MudRunnerBaja/Eletronica/documentação/Placa do Display/Relatório Placa do Display.docx

# INTRODUÇÃO

Por conta do sucateamento da placa do display do carro e a alta dificuldade de manutenção, o subsistema de eletrônica optou por manufaturar uma nova placa do display.

# SUMÁRIO

# 1. OBJETIVO

Reduzir a frequência e a dificuldade de manutenção da placa através da manufatura de uma nova placa, além do aprimoramento do design e da documentação da placa e de seus componentes.

# 2. METODOLOGIA

O projeto e design da placa foi feito no software Fusion 360 da Autodesk. As medidas do capô e dos displays foram tiradas com um paquímetro. A partir das medidas, foram calculadas as margens de erro para o posicionamento dos displays e leds na placa. Optou-se por usar 1cm de margem exterior na placa. Por fim, as dimensões finais da placa são:

# 3. APRESENTAÇÃO

As dimensões da placa foram calculadas e documentadas no design de placas de circuitos impressos do Fusion 360 da Autodesk. Uma print pode ser vista no anexo (1ª figura). A segunda figura representa o design das trilhas da placa, inspirado na placa antiga.

O projeto das trilhas foi feito pensando na facilitação da confecção das trilhas da placa. Os pinos de entrada da placa não estão alinhados com os pinos na placa principal, porém, como os fios serão soldados na placa, pode-se rearranjá-los de forma que seus conectores se alinhem com a placa principal. Essa escolha é baseada na placa antiga e a ideia é representada pela figura 3.

## 3.1. COMPONENTES

A- 4 x displays 7 segmentos 1,2 polegadas, vermelho anodo comum;
B- Placa de Fenolite (Mínimo: 18x8cm);
C- Percloreto de Ferro;
D- Caneta Permanente Retroprojetora;
E- 5 x leds (2 vermelhos, 1 amarelo, 1 verde e 1 azul);
F- Chave Alavanca HH/ 2 posições;
G- Fios Jumper;
H- 2 x Parafusos;
I- 2 x Porcas;
J- Adesivos para o capô;

# 4. CONCLUSÃO

O subsistema de eletrônica tem como objetivo aumentar a confiabilidade de sua placa do painel, para garantir a visualização de dados pelo piloto durante a competição, por isso foi decidido a confecção de uma nova placa pelos membros na própria oficina, devido aos custos maiores necessários para caso fosse mandada para fabricação devido ao tamanho da placa. Além disso, foram confeccionados novos adesivos (https://cefetrjbr.sharepoint.com/sites/mudrunner/Prottipo/Forms/AllItems.aspx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) para o capô, facilitando assim a identificação de cada um dos itens do painel.

# 5. ANEXOS

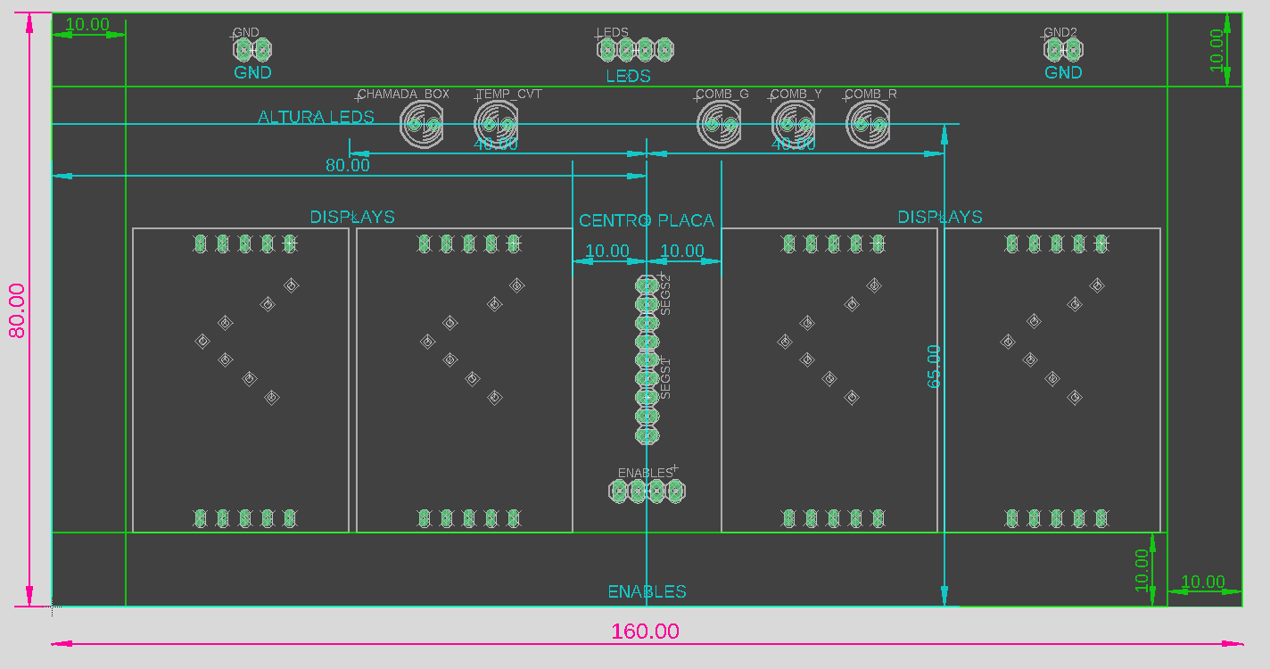
[picture p1: figure]

1 - Medidas da placa do display.

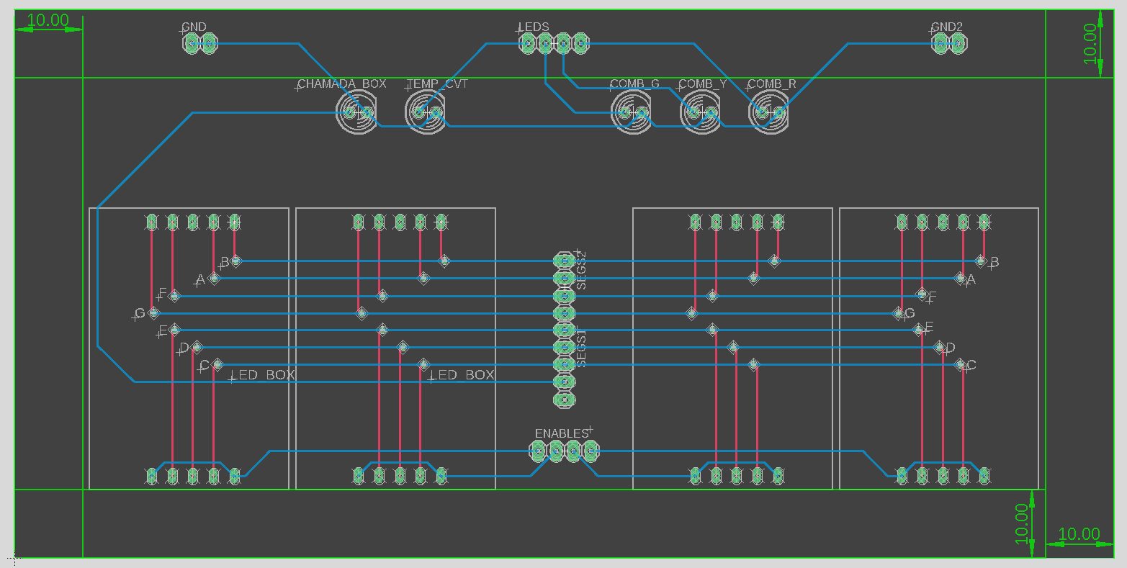
[picture p2: figure]

2 – Trilhas, vias e furos da placa do display – Vista posterior

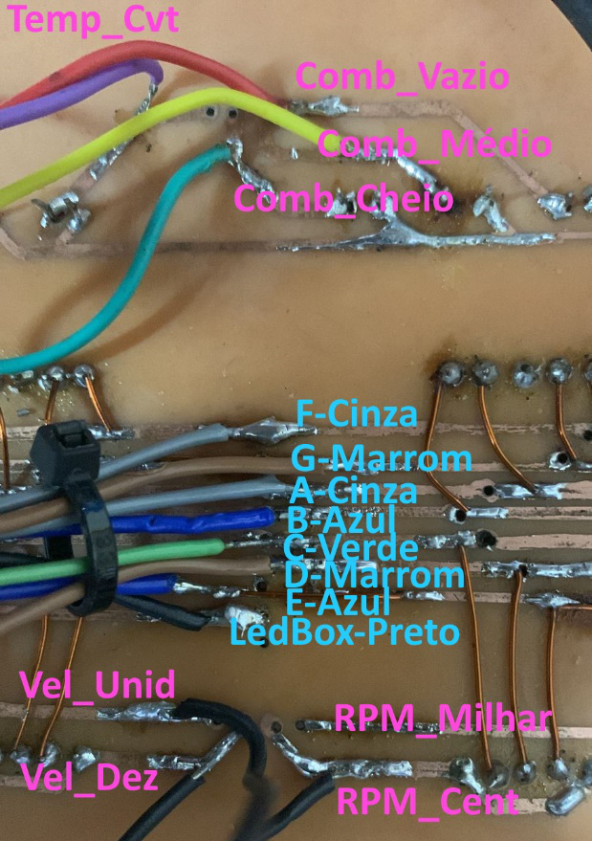
[picture p3: figure]
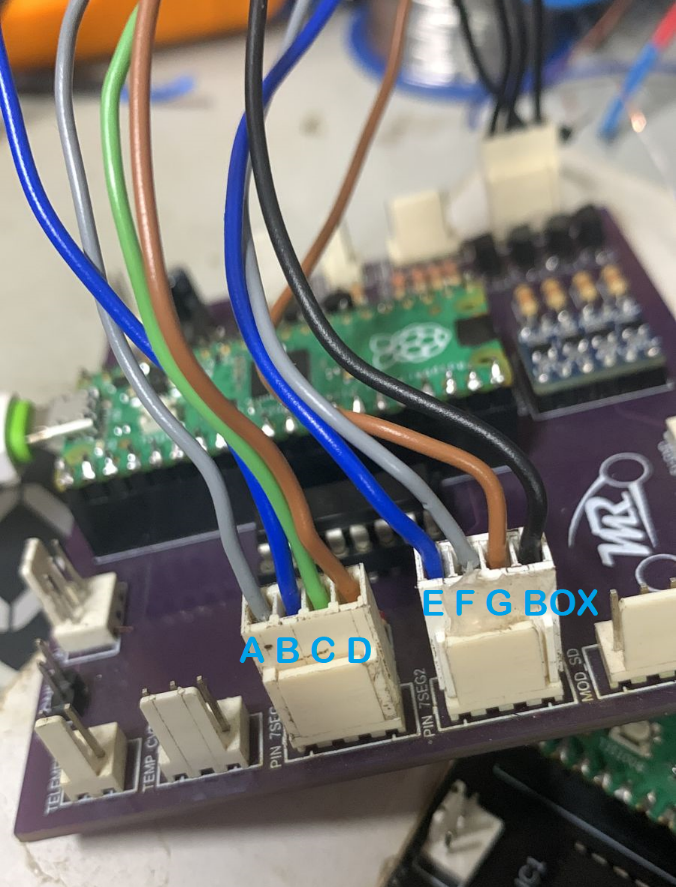
[picture p4: figure]

3 – Conexões Entre Placa Principal e Placa do Display

PROCEDIMENTO Cód.: QMR-01 SISTEMA DA QUALIDADE

RELATÓRIO DA PLACA DO DISPLAY DATA: 13/08/2022 Pág.: 1/4
