MudRunnerBaja/Eletronica/codigos/Competição/RaspbabyPico/main/documentos/Pinout Pico.jpeg

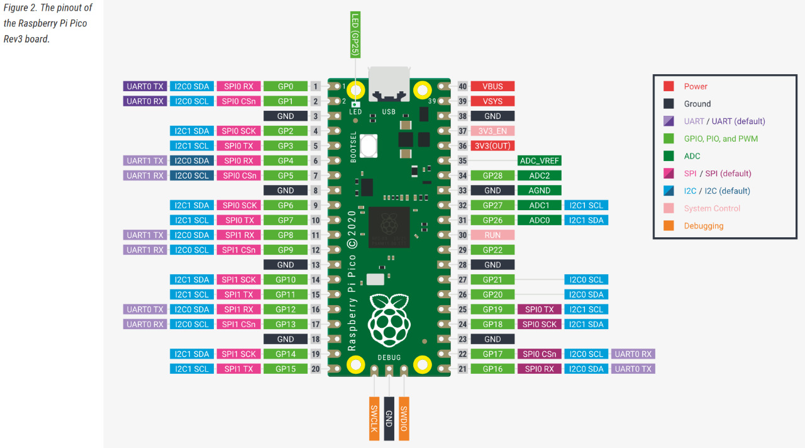
codigos/Competição/RaspbabyPico/main/documentos/Pinout Pico.jpeg
