MudRunnerBaja/Eletronica/descontinuado/PIC (Descontinuado)/codigoAntigo/projetoAntigo.PNG

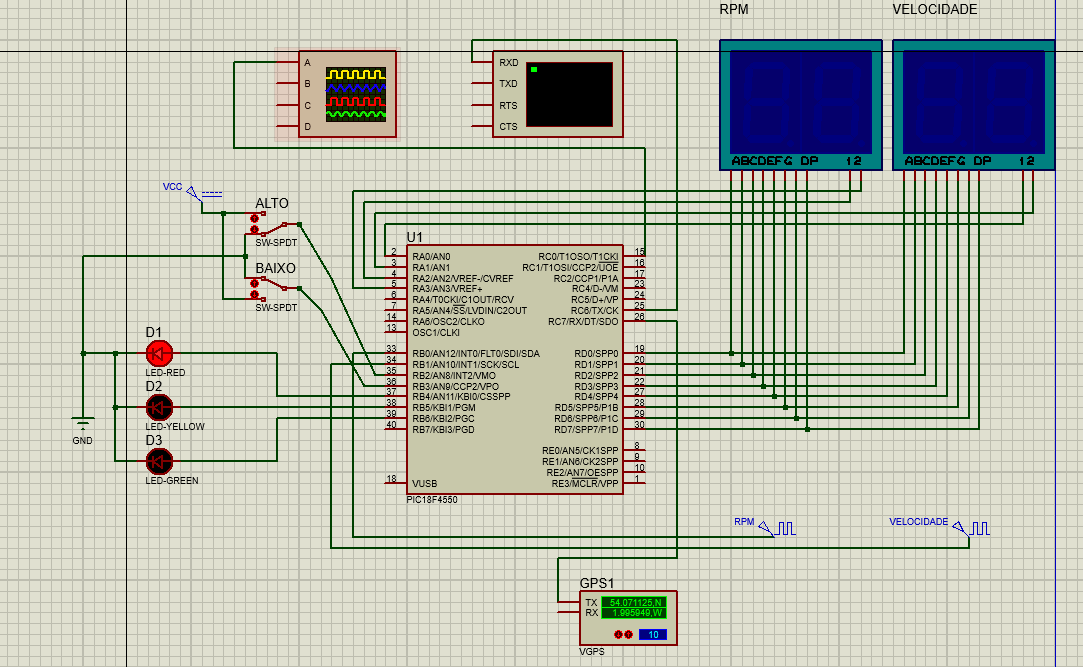
descontinuado/PIC (Descontinuado)/codigoAntigo/projetoAntigo.PNG
