MudRunnerBaja/Eletronica/descontinuado/PIC (Descontinuado)/documentos/Circuito/circuitoCompleto.PNG

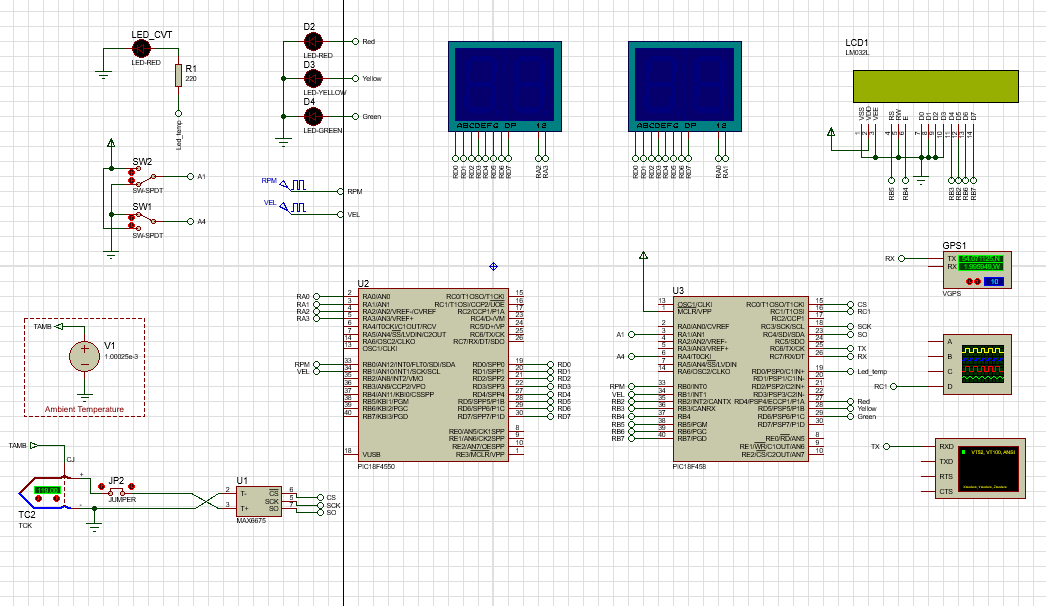
descontinuado/PIC (Descontinuado)/documentos/Circuito/circuitoCompleto.PNG
