MudRunnerBaja/Eletronica/descontinuado/PIC (Descontinuado)/ultimaVersão/simulação.PNG

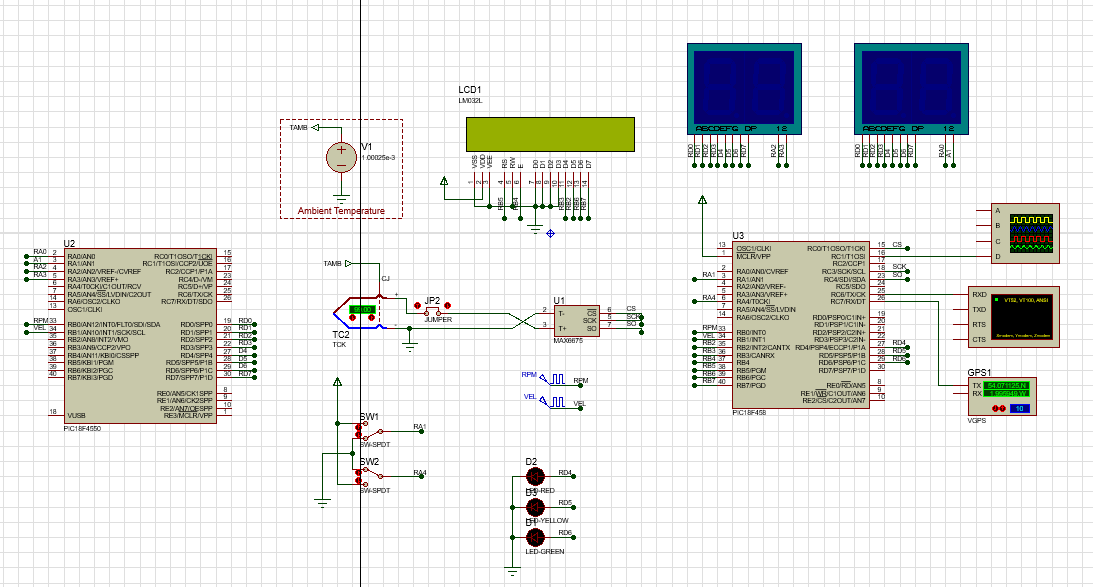
descontinuado/PIC (Descontinuado)/ultimaVersão/simulação.PNG
