MudRunnerBaja/Eletronica/documentação/Placa do Display/Conexoes Display Principal.png

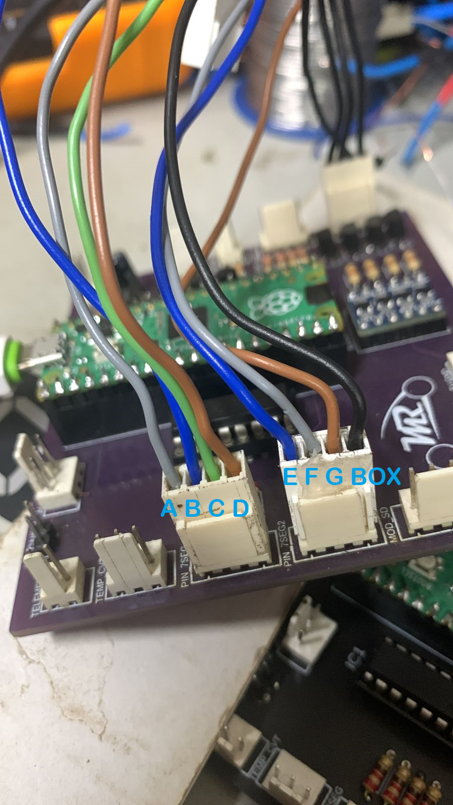
documentação/Placa do Display/Conexoes Display Principal.png
