MudRunnerBaja/Eletronica/documentação/Placa do Display/Cores Display e 7 Segmentos.png

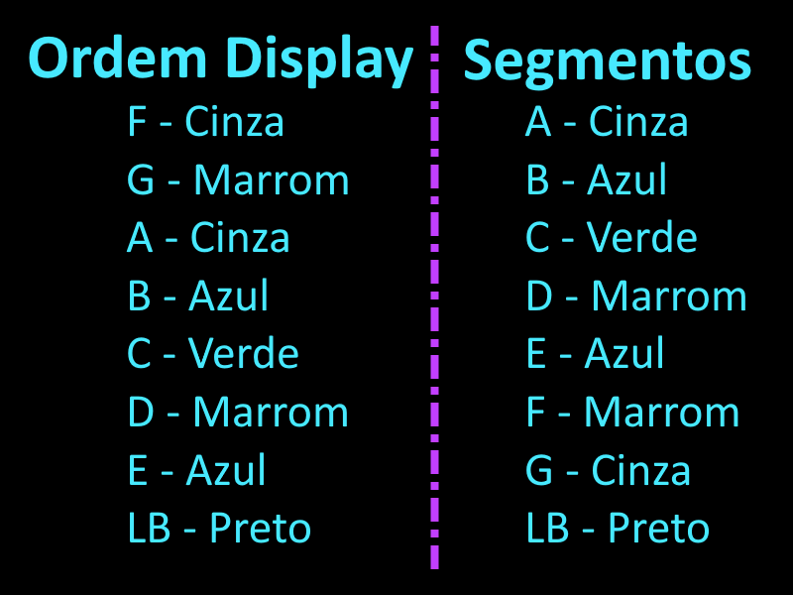
documentação/Placa do Display/Cores Display e 7 Segmentos.png
