MudRunnerBaja/Eletronica/documentação/Placa do Display/Traseira Placa Display.png

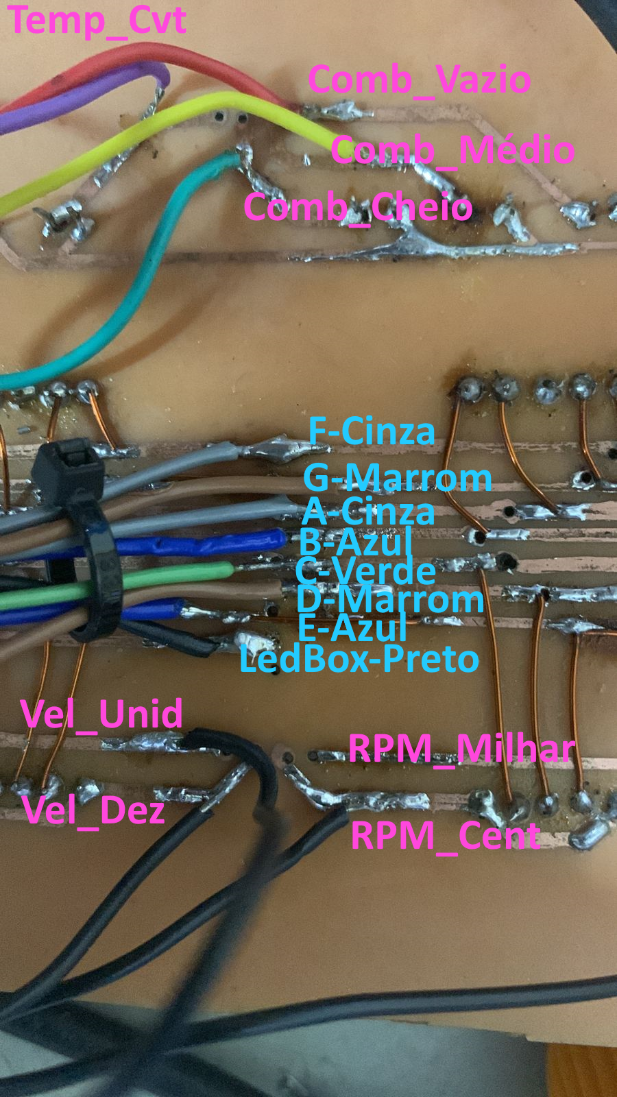
documentação/Placa do Display/Traseira Placa Display.png
