MudRunnerBaja/Eletronica/documentação/Placa Principal/Filtro RPM 2022.png

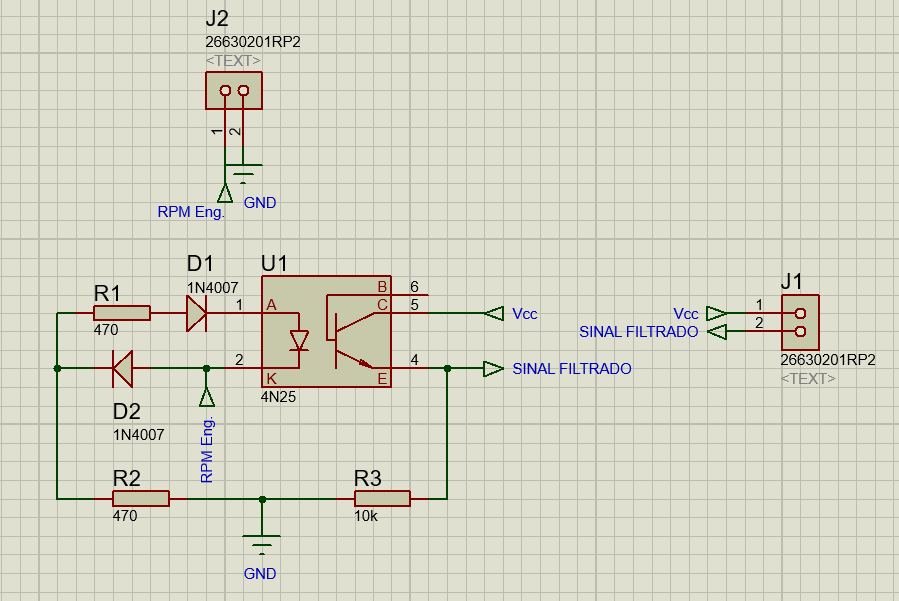
documentação/Placa Principal/Filtro RPM 2022.png
