MudRunnerBaja/Eletronica/documentação/Placa Principal/Pinos Raspbaby.png

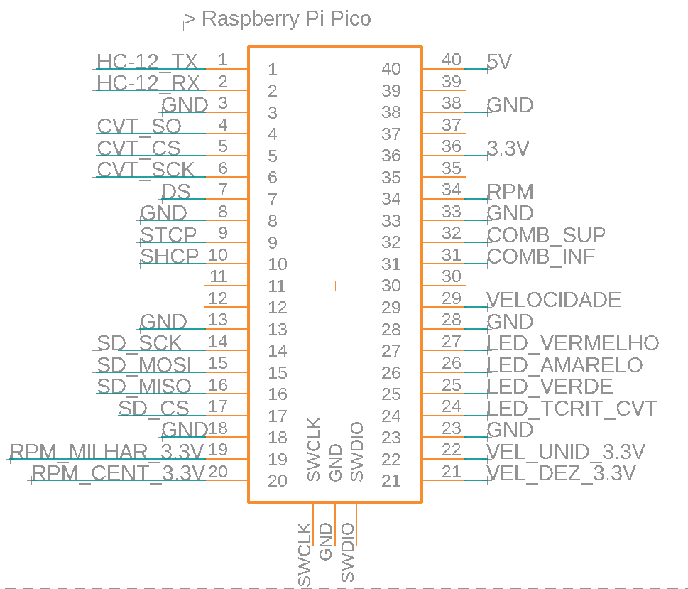
documentação/Placa Principal/Pinos Raspbaby.png
