MudRunnerBaja/Eletronica/documentação/Placa Principal/Placa Principal - Posição dos sistemas.png

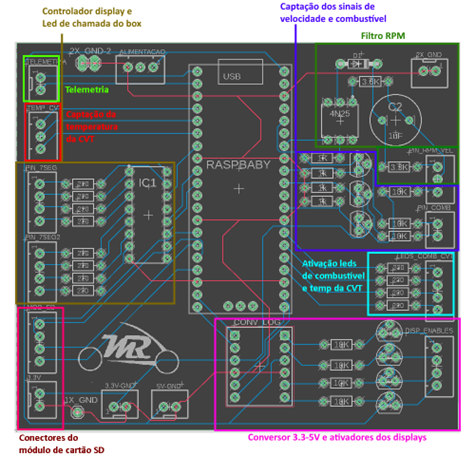
documentação/Placa Principal/Placa Principal - Posição dos sistemas.png
