MudRunnerBaja/Eletronica/telemetria/Front-End/images/Escudo.png

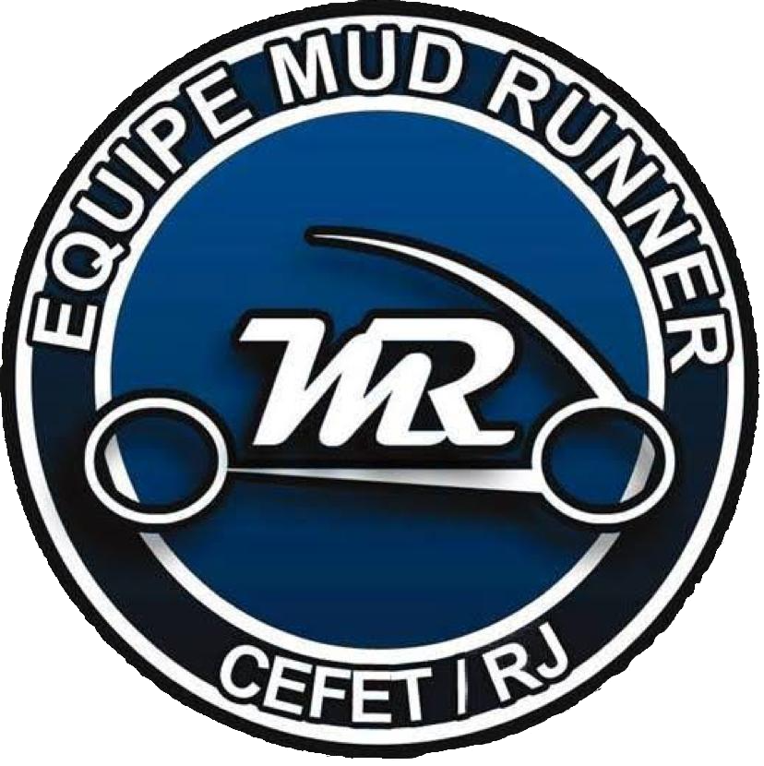
telemetria/Front-End/images/Escudo.png
