MudRunnerBaja/Eletronica/telemetria/Sistema_tema_equipe/Sistema/web/assets/background.png

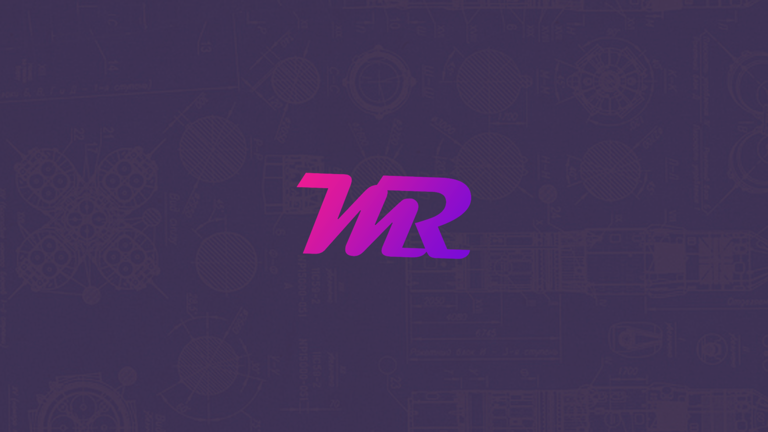
telemetria/Sistema_tema_equipe/Sistema/web/assets/background.png
