MudRunnerBaja/Eletronica/(list of files, cad)

Other CAD files:
codigos/Competição/RaspbabyPico/main/documentos/Esquematico MR-22/KiCad-RP-Pico-main/KiCad-RP-Pico-main/SketchUp Model/Pico.skp
documentação/Fiação MR21/Fusion360/Fiação MR21 v8.f3z
