MudRunnerBaja/Eletronica/documentação/Fiação MR21/Montagem da Fiação-1.png

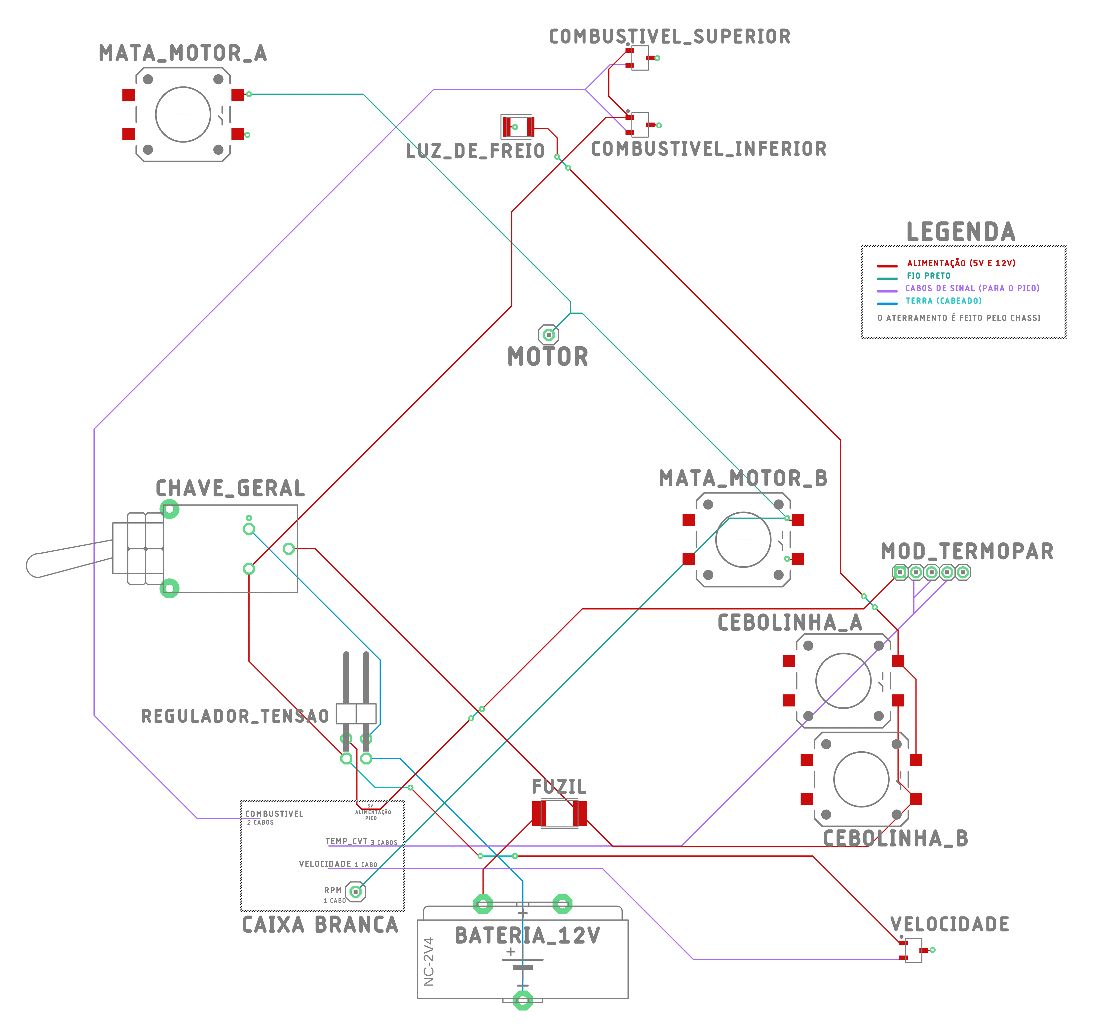
documentação/Fiação MR21/Montagem da Fiação-1.png
