MudRunnerBaja/Eletronica/documentação/Placa Principal/Placa Principal PrintTrilhas.png

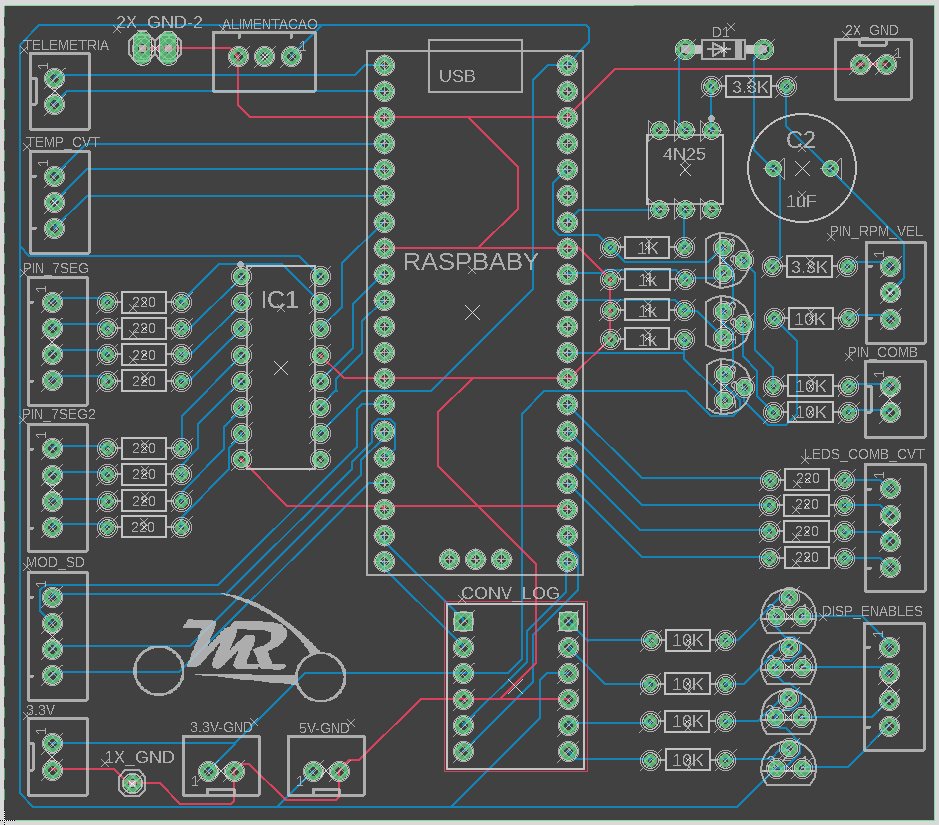
documentação/Placa Principal/Placa Principal PrintTrilhas.png
