MudRunnerBaja/Eletronica/testes/00-Testes_PIC/StrainGauge/simulacao.PNG

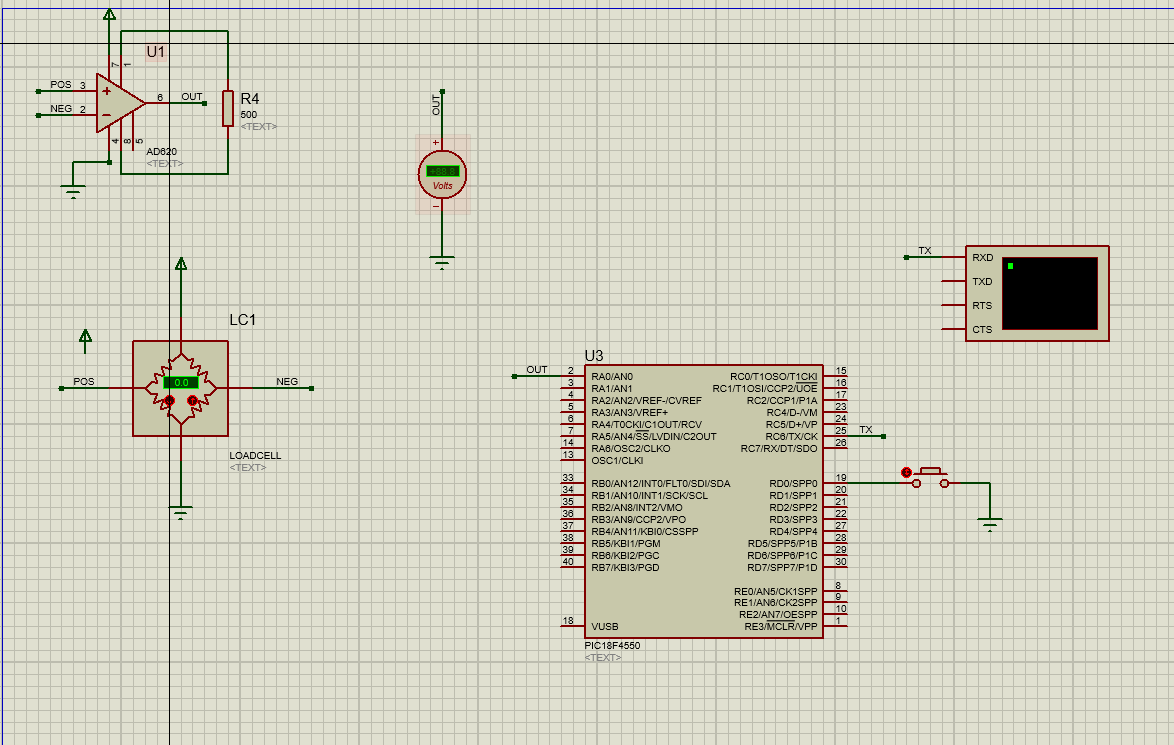
testes/00-Testes_PIC/StrainGauge/simulacao.PNG
