MudRunnerBaja/Eletronica/testes/00-Testes_PIC/TemperaturaCvt/testeTempCvt.PNG

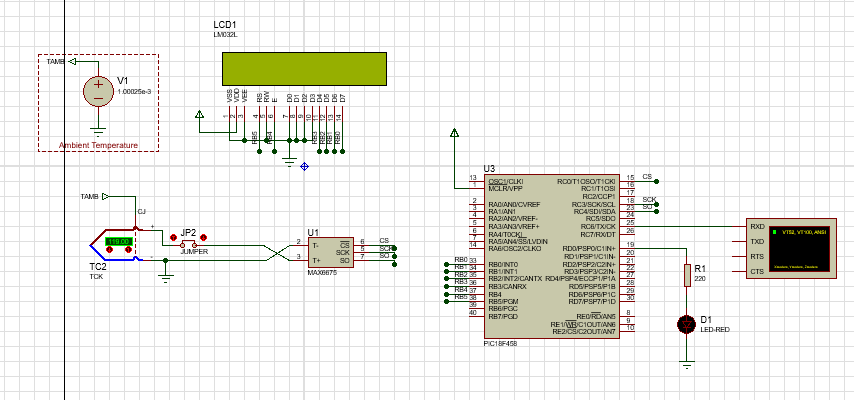
testes/00-Testes_PIC/TemperaturaCvt/testeTempCvt.PNG
