MudRunnerBaja/Eletronica/testes/ChamadaParaBox/simulacaoProteus/box.PNG

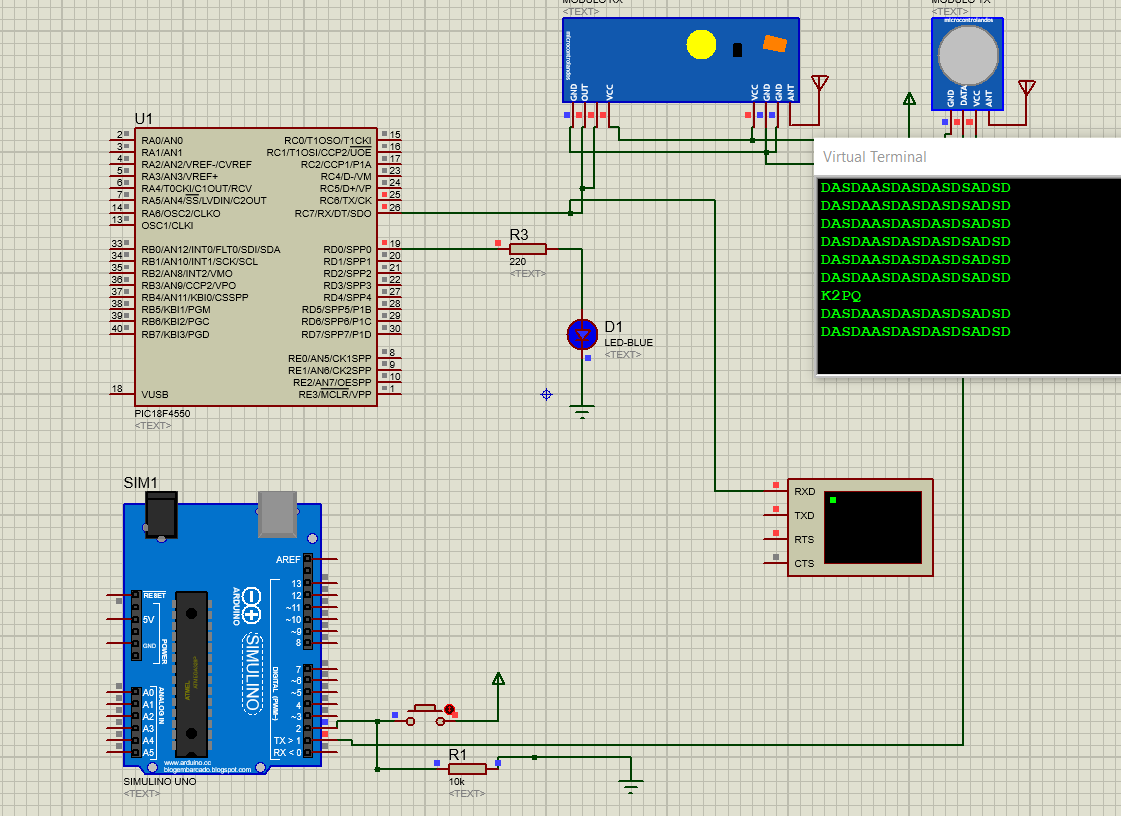
testes/ChamadaParaBox/simulacaoProteus/box.PNG
