MudRunnerBaja/Eletronica/testes/GPS/testeGps.PNG

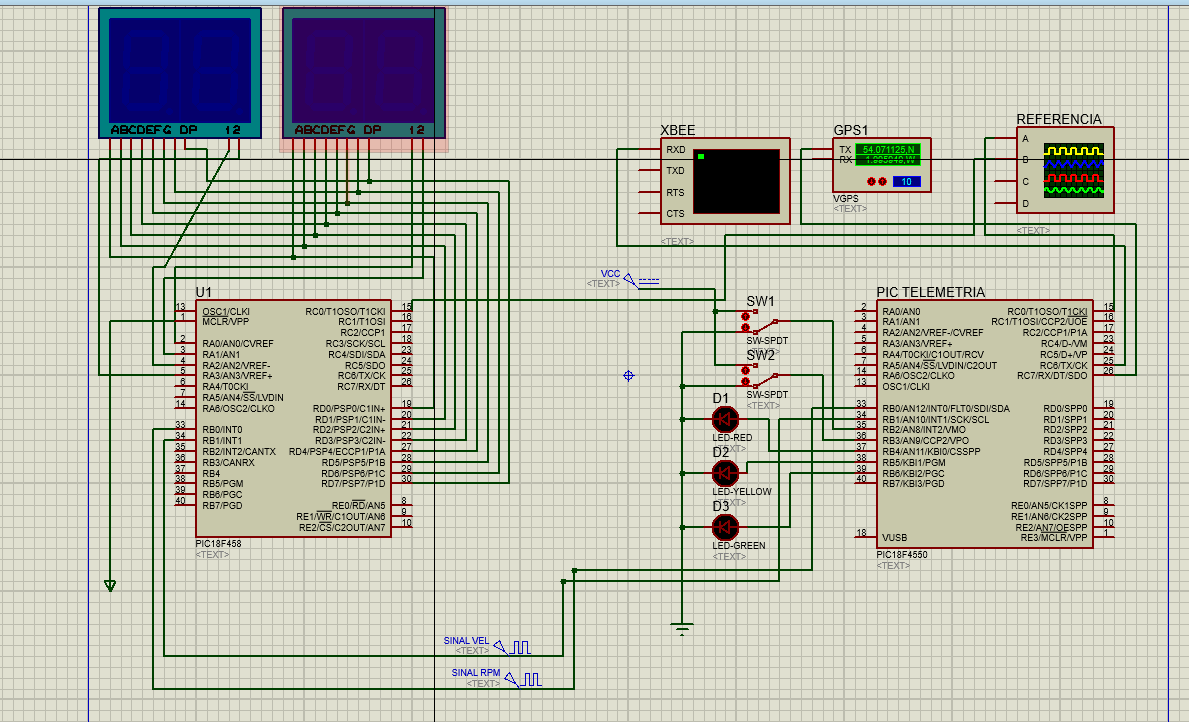
testes/GPS/testeGps.PNG
