MudRunnerBaja/Eletronica/testes/MedidorDeCombustível/Medidor_de_Combustível .png

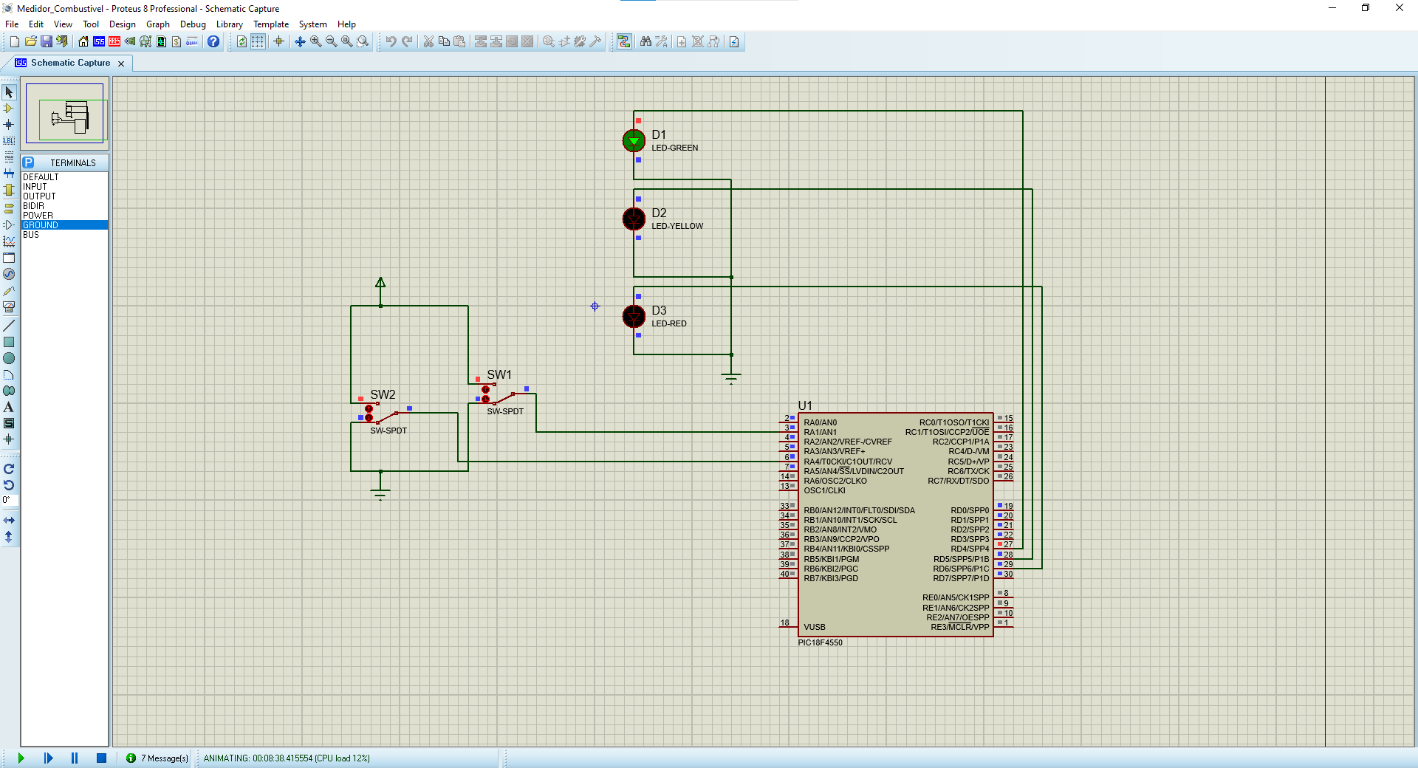
testes/MedidorDeCombustível/Medidor_de_Combustível .png
