MudRunnerBaja/Eletronica/testes/RPM/Teste_rpm_circuitonovo.jpg

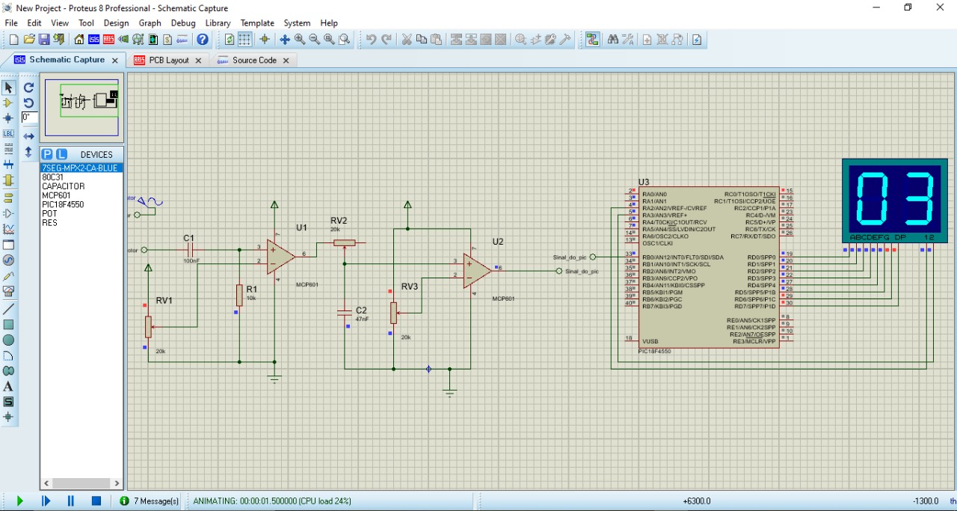
testes/RPM/Teste_rpm_circuitonovo.jpg
