MudRunnerBaja/Eletronica/testes/RPM/Teste_rpm_filtro_2.png

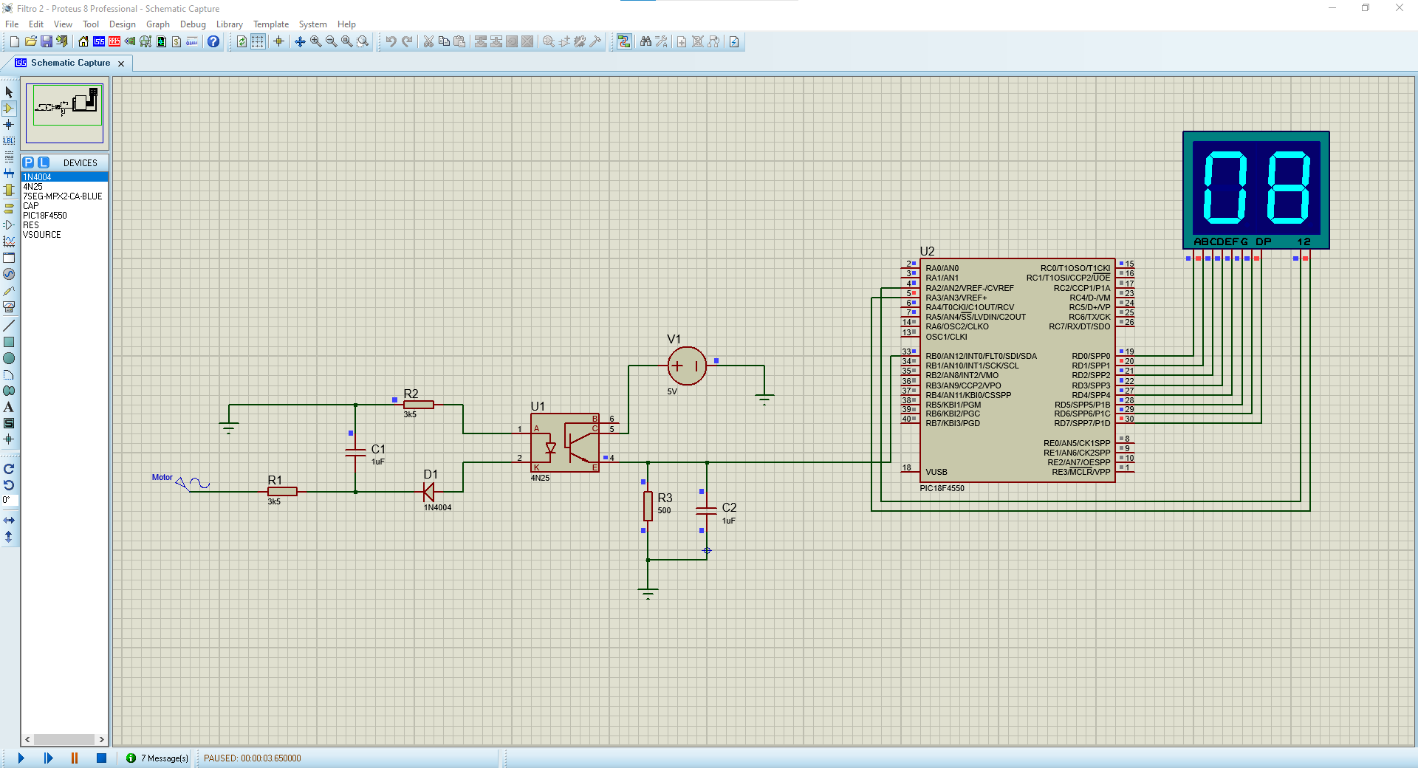
testes/RPM/Teste_rpm_filtro_2.png
