MudRunnerBaja/Eletronica/documentação/Adesivos/Antigos.pdf

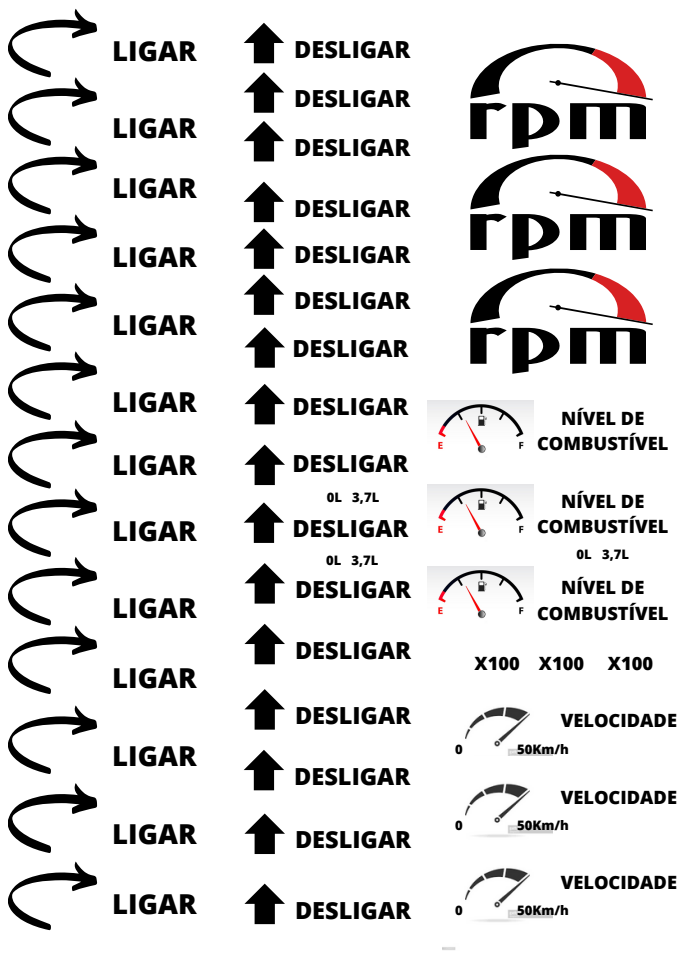
[picture p49: page 1]
NÍVEL DE COMBUSTÍVEL; LIGAR; DESLIGAR; DESLIGAR DESLIGAR; VELOCIDADE
