MudRunnerBaja/Eletronica/documentação/Fiação MR21/Montagem da Fiação.pdf

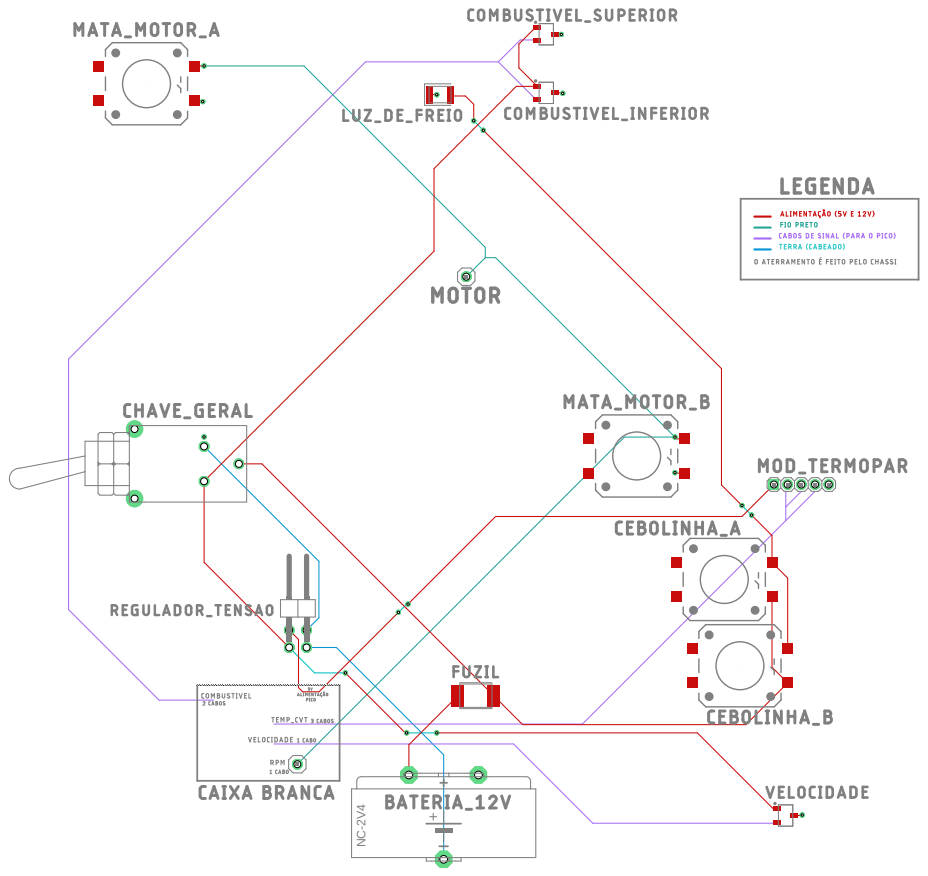
[picture p50: page 1]
