MudRunnerBaja/Eletronica/documentação/Placa central MR24/Placa central MR24.pdf

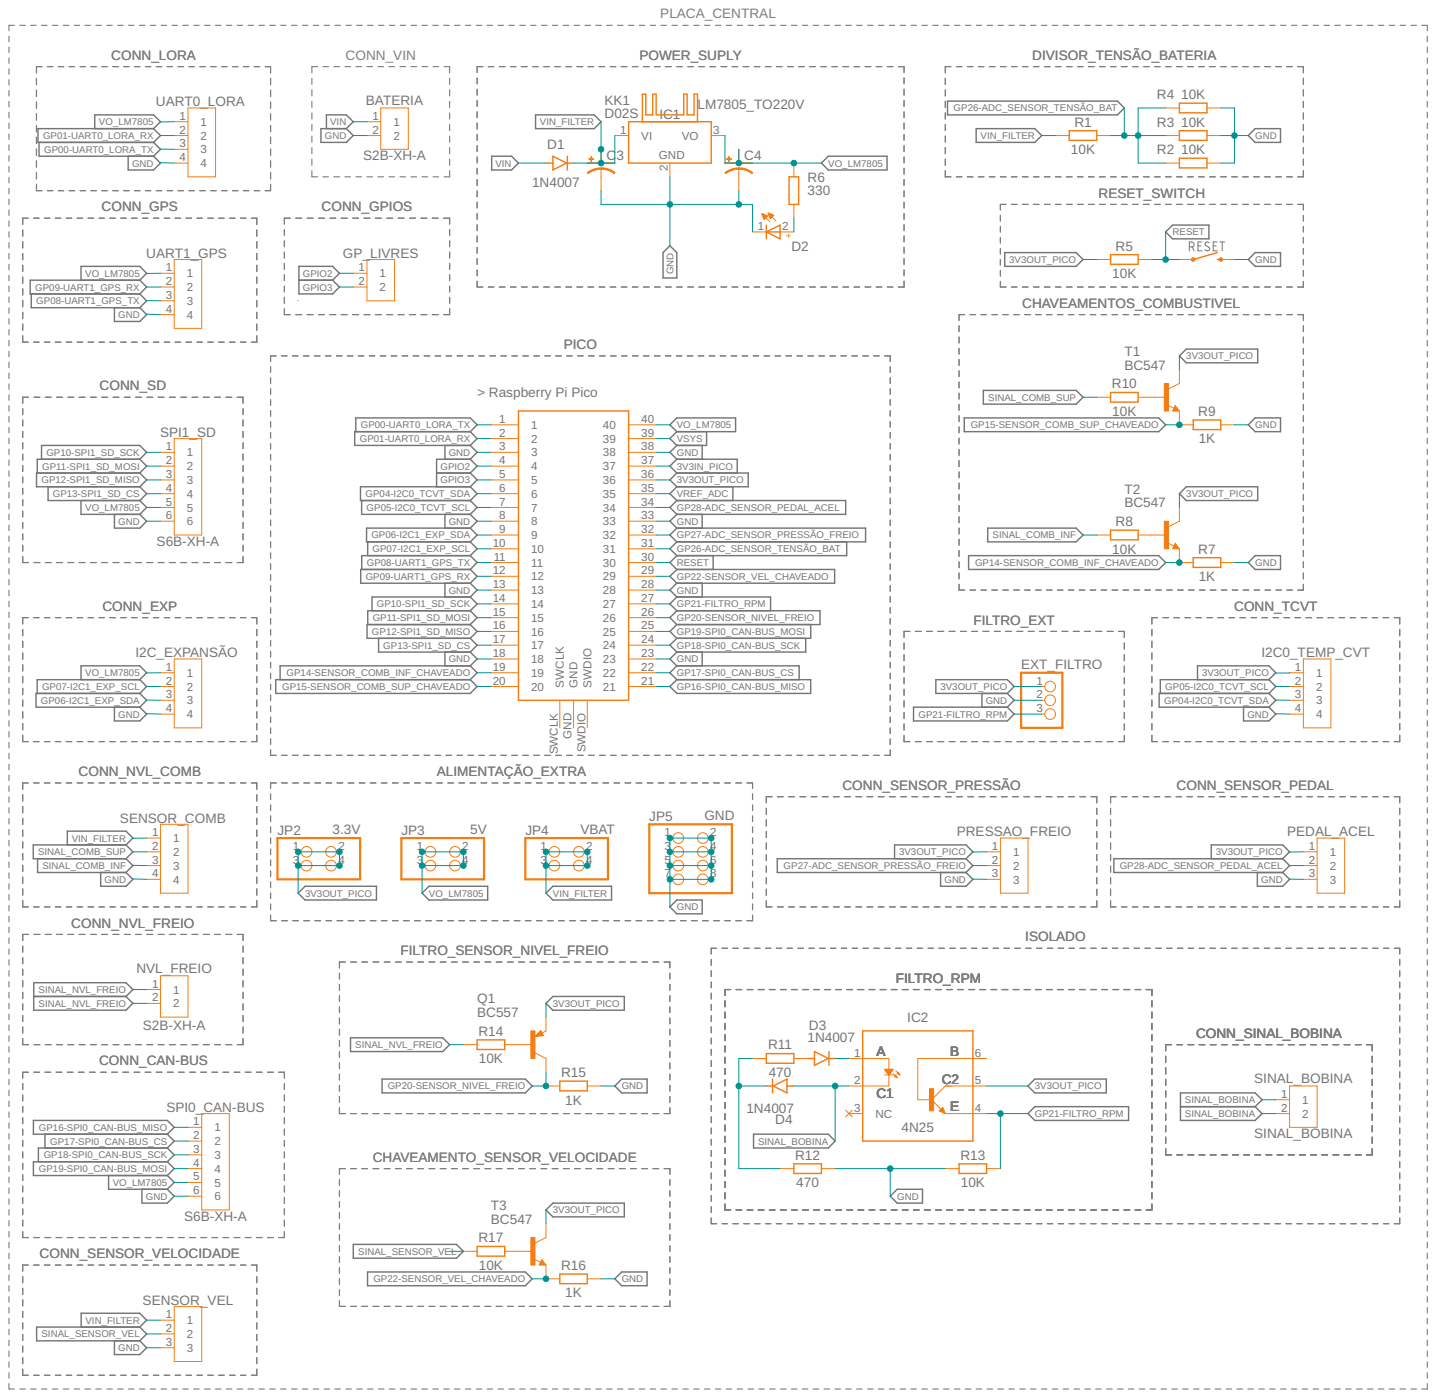
[picture p51: page 1]
