MudRunnerBaja/Eletronica/documentação/Fiação MR21/Fiação MR21 v1 BLACK.pdf

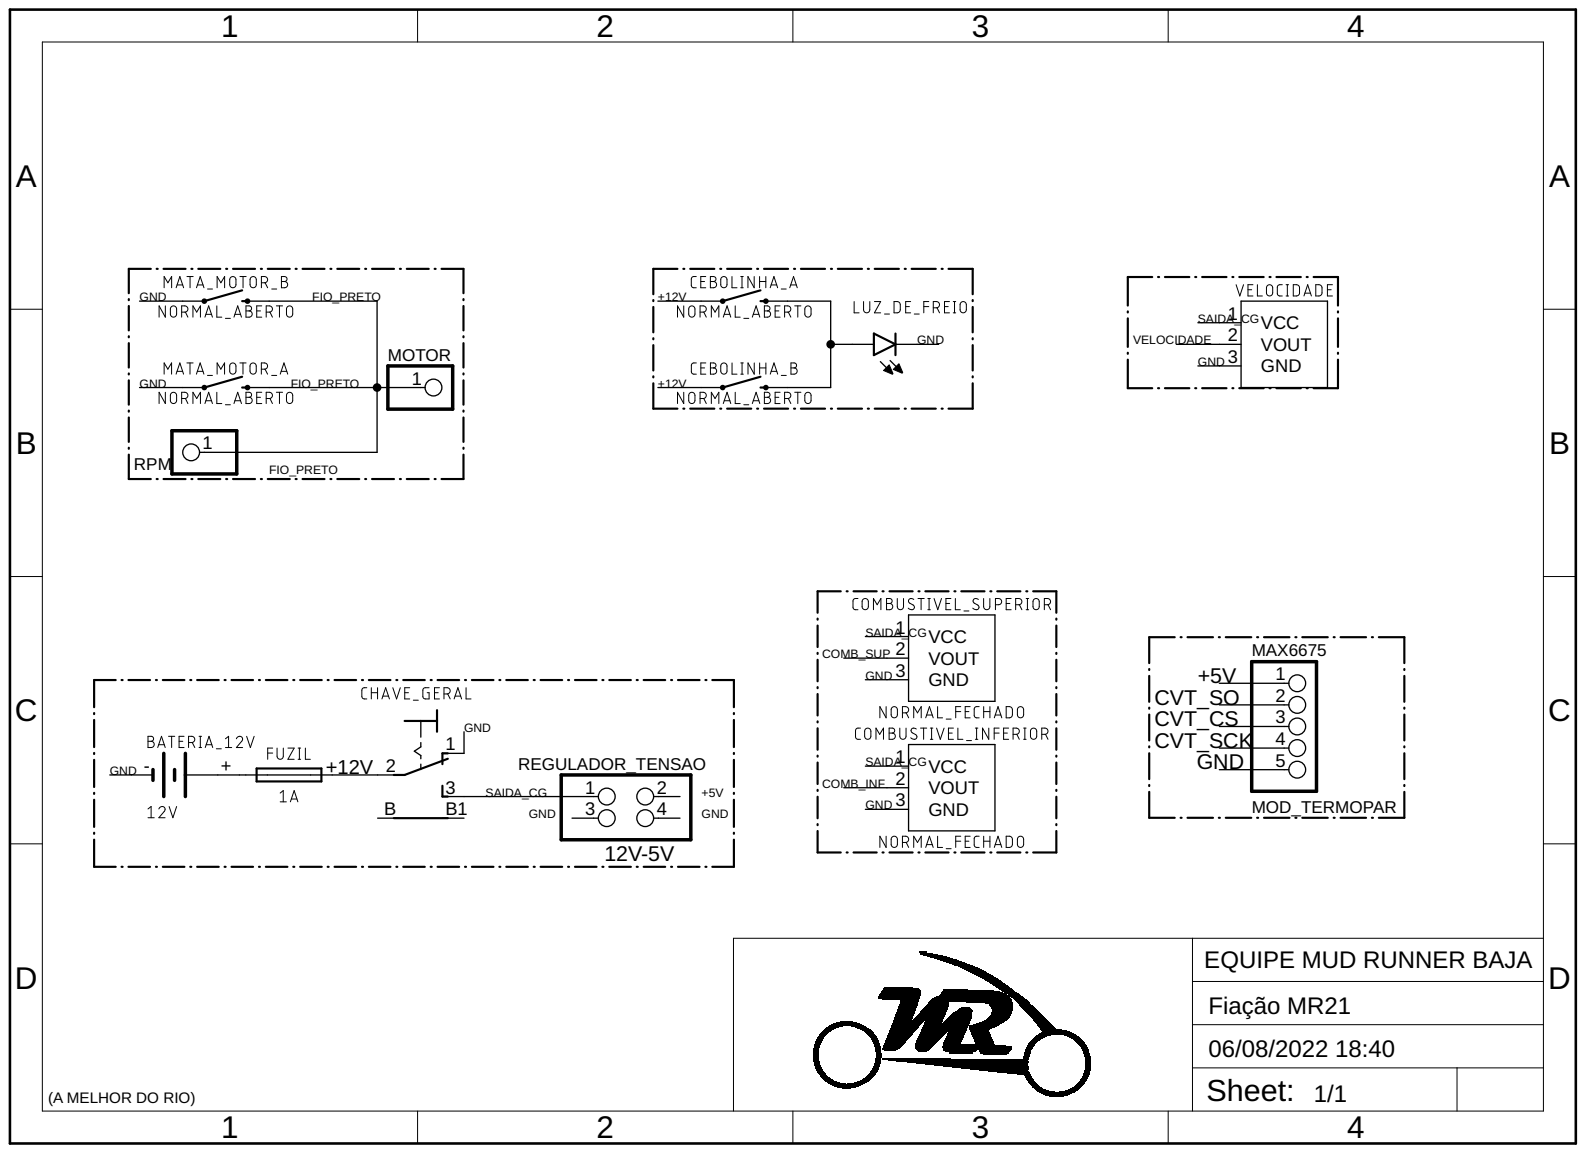
[picture p52: page 1]

EQUIPE MUD RUNNER BAJA
