MudRunnerBaja/Eletronica/documentação/Fiação MR21/Fiação MR21 v1 COLORIDO.pdf

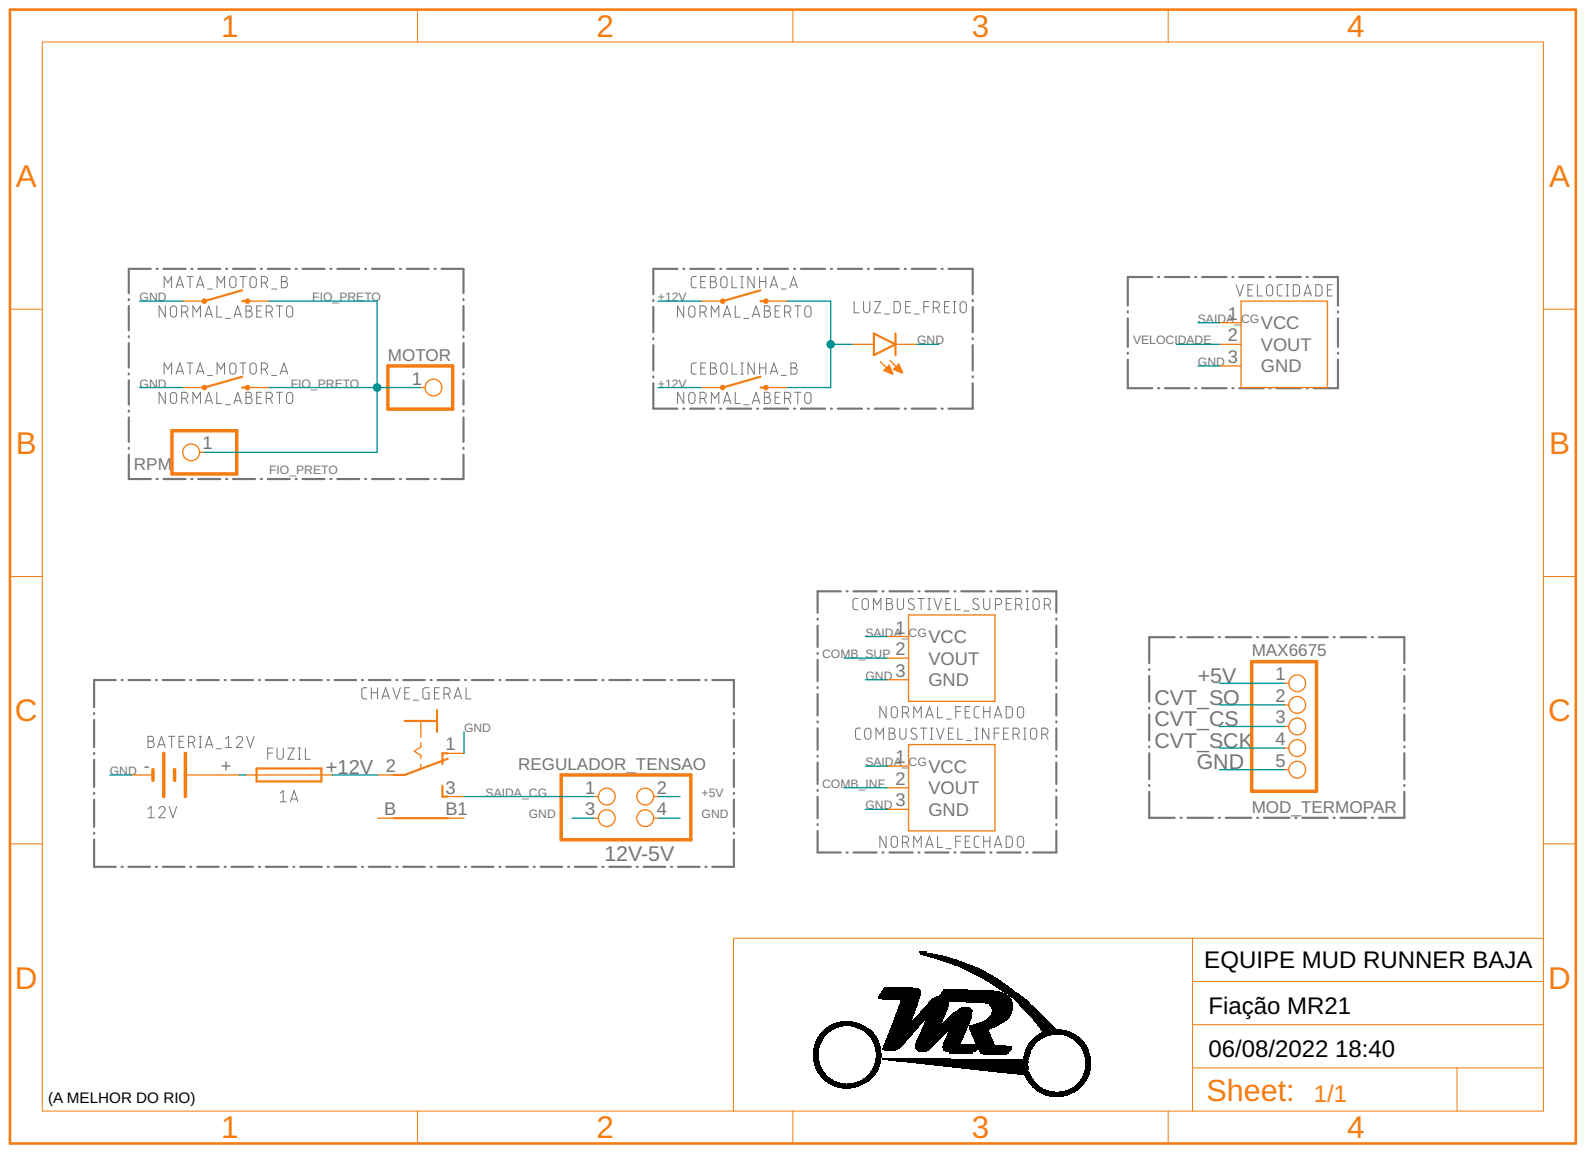
[picture p53: page 1]

EQUIPE MUD RUNNER BAJA
