MudRunnerBaja/Eletronica/documentação/Placa Principal/Esquematica Placa Principal.pdf

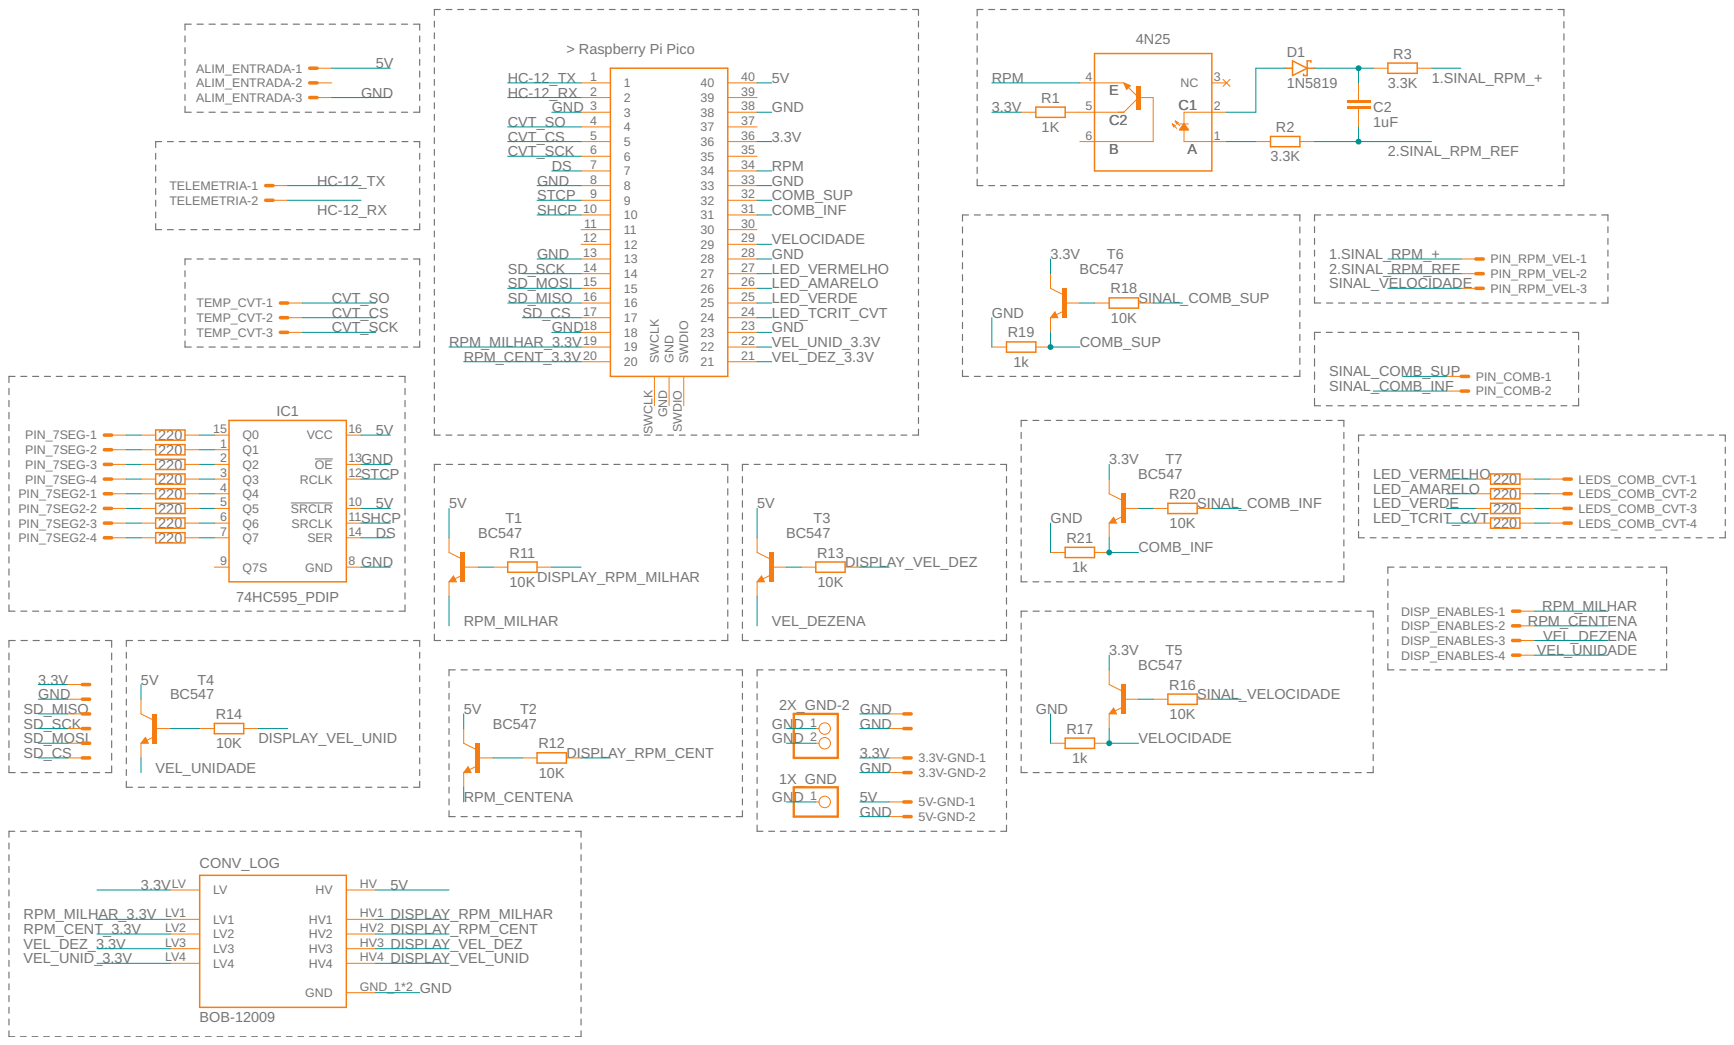
[picture p54: page 1]
