MudRunnerBaja/Eletronica/documentação/Placa Principal/Placa Principal Esquematica.pdf

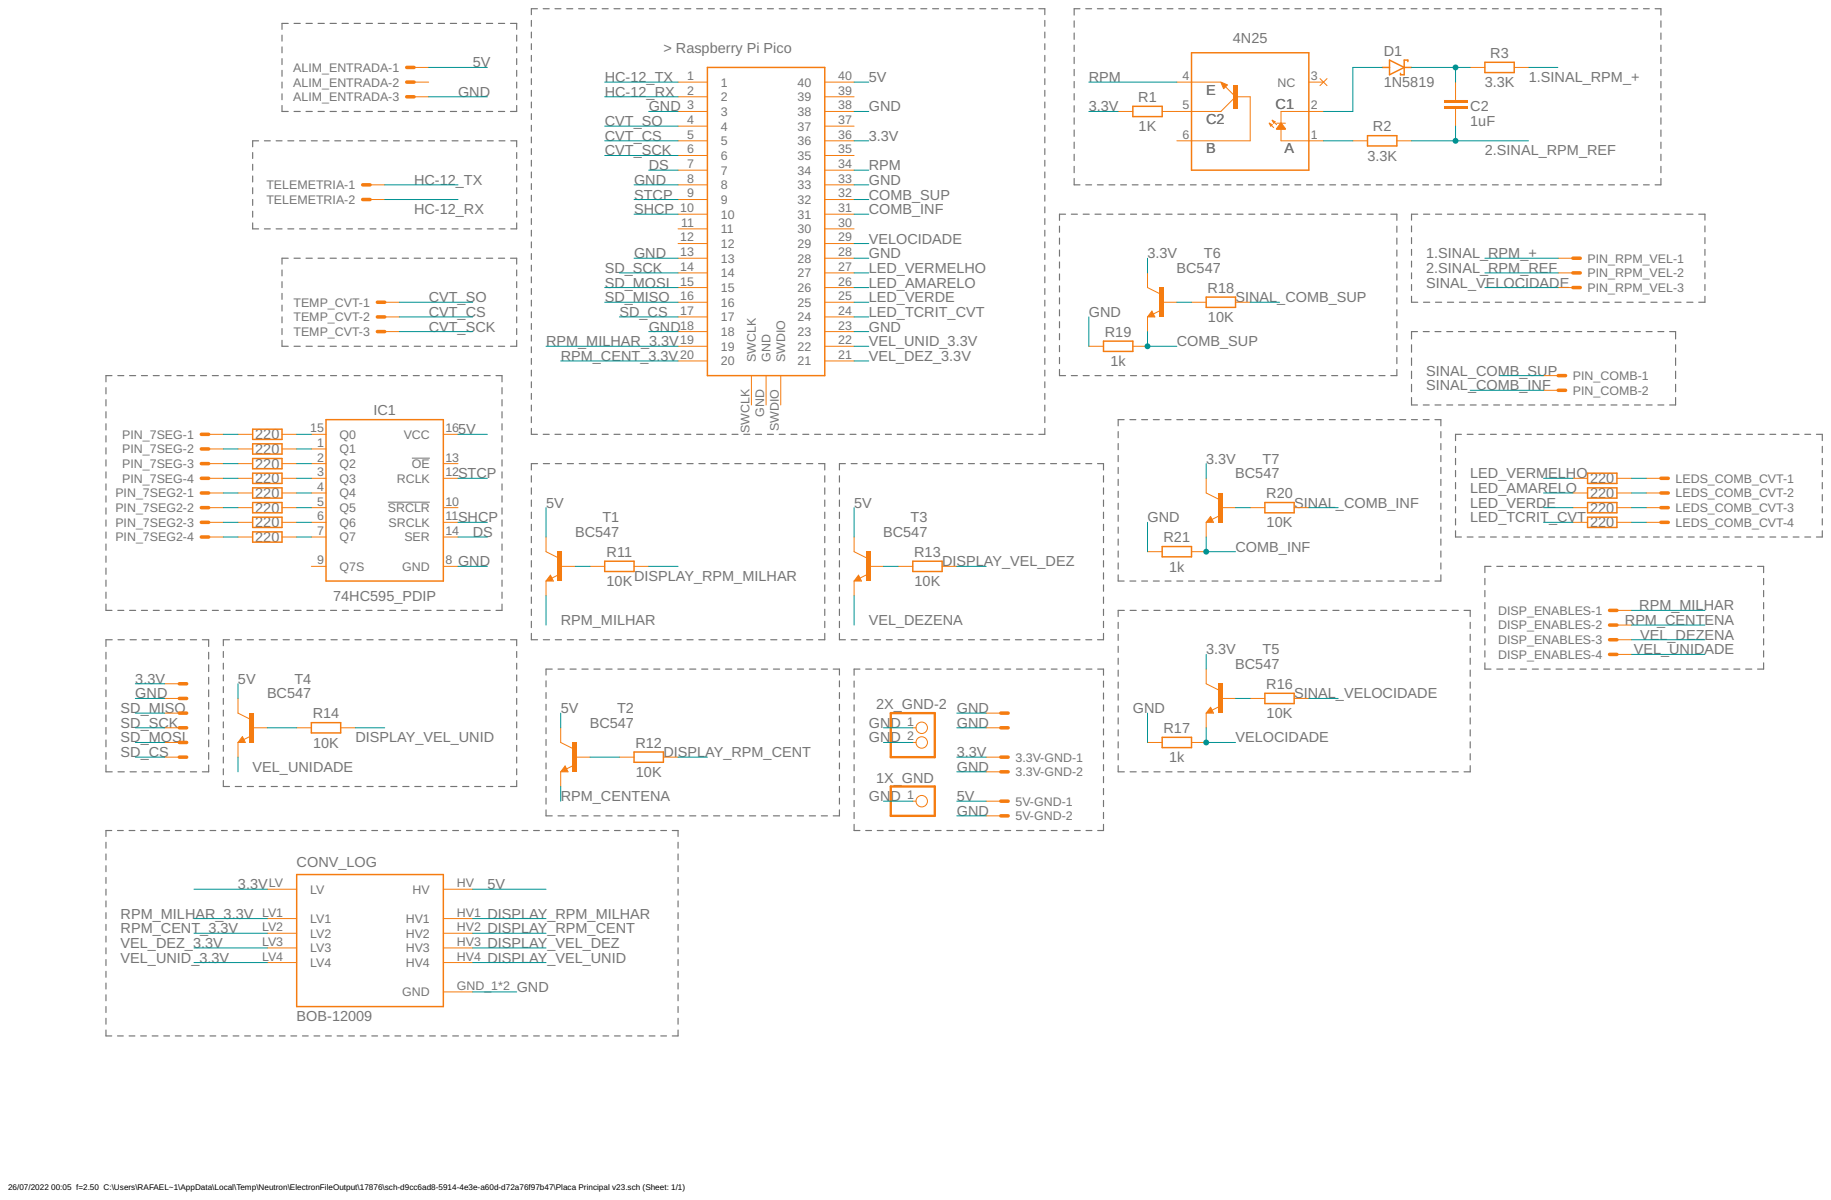
[picture p55: page 1]

26/07/2022 00:05 f=2.50 C:\Users\RAFAEL~1\AppData\Local\Temp\Neutron\ElectronFileOutput\17876\sch-d9cc6ad8-5914-4e3e-a60d-d72a76f97b47\Placa Principal v23.sch (Sheet: 1/1)
