MudRunnerBaja/Eletronica/documentação/Placa Principal/Placa Principal PDF_FundoPlaca(Trilhas).pdf

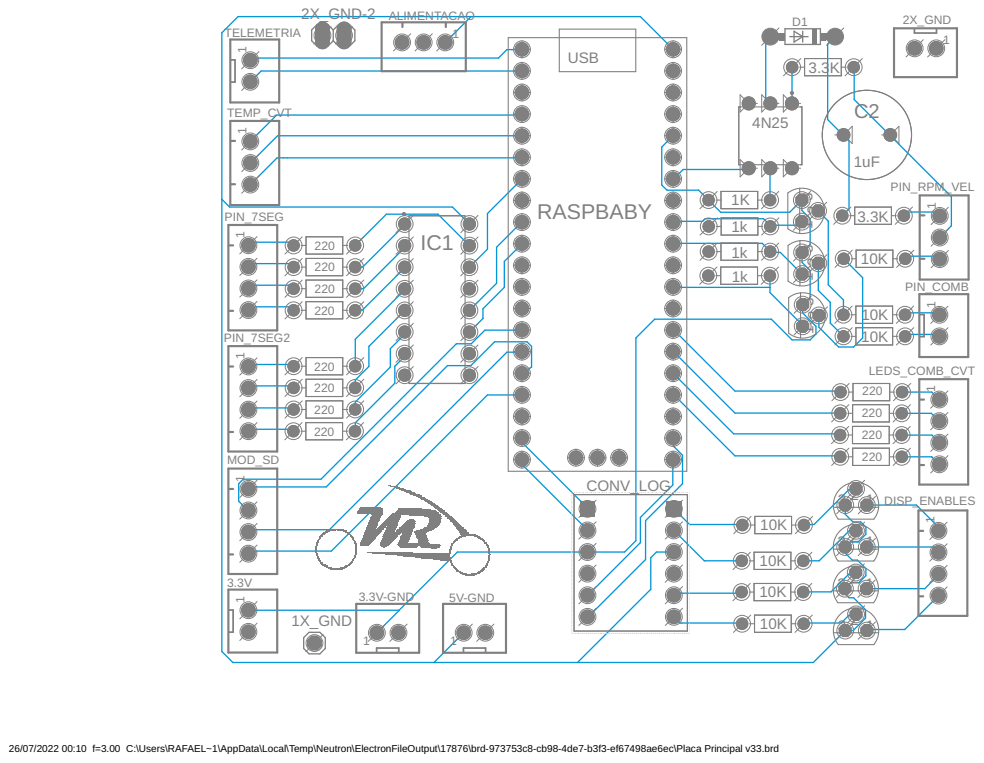
[picture p56: page 1]

26/07/2022 00:10 f=3.00 C:\Users\RAFAEL~1\AppData\Local\Temp\Neutron\ElectronFileOutput\17876\brd-973753c8-cb98-4de7-b3f3-ef67498ae6ec\Placa Principal v33.brd
