MudRunnerBaja/Eletronica/(list of files, drawings)

Other design files:
descontinuado/PIC (Descontinuado)/codigoAntigo/projetoAntigo.pdsprj
descontinuado/PIC (Descontinuado)/documentos/Circuito/Circuito_completo.pdsprj
descontinuado/PIC (Descontinuado)/ultimaVersão/ultimaVersao.pdsprj
documentação/Placa Principal/Filtro RPM 2022.pdsprj
testes/00-Testes_PIC/StrainGauge/gauge.pdsprj
testes/00-Testes_PIC/StrainGauge/testeStrainGauge.pdsprj
testes/00-Testes_PIC/TemperaturaCvt/testeTempCvt.pdsprj
testes/ChamadaParaBox/simulacaoProteus/box.pdsprj
testes/CoeficienteDeAtrito/coeficiente_de_atrito.pdsprj
testes/GPS/testeGps.pdsprj
testes/MedidorDeCombustível/Medidor_Combustível.pdsprj
testes/RPM/RPM_Bancada/RPM.pdsprj
testes/RPM/Teste_rpm_circuitonovo.pdsprj
testes/RPM/Teste_rpm_filtro_2.pdsprj
