MudRunnerBaja/Eletronica/codigos/Competição/RaspbabyPico/main/documentos/Esquematico MR-22/main/main.kicad_pcb

## KiCad design codigos/Competição/RaspbabyPico/main/documentos/Esquematico MR-22/main/main.kicad_pcb (2022-07-26)

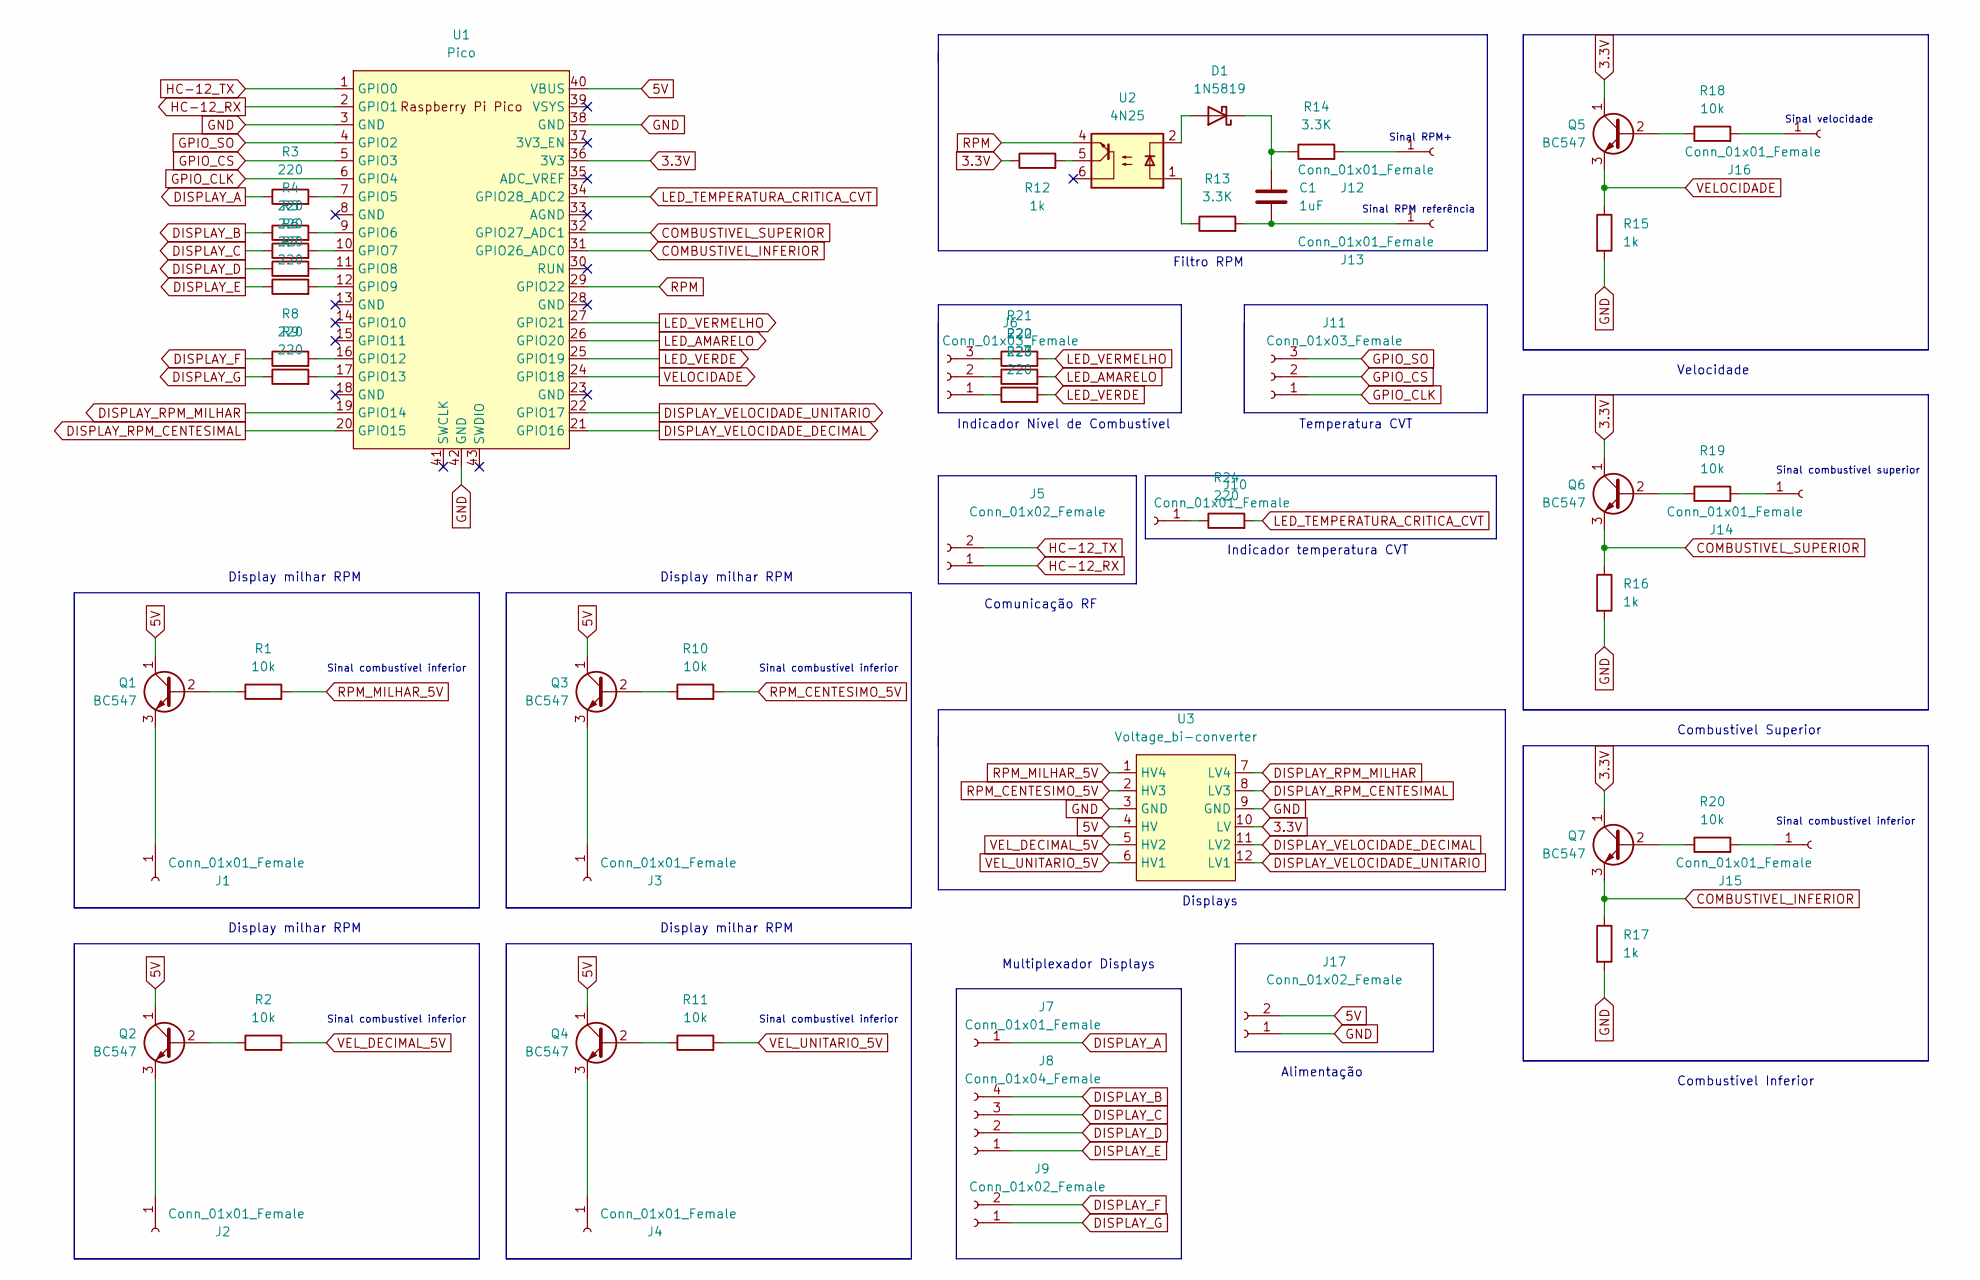
[picture p57: schematic main.kicad_sch]

Parts:
C1: 1uF; CP_Radial_D5.0mm_P2.00mm
D1: 1N5819; D_DO-41_SOD81_P10.16mm_Horizontal
J1, J2, J3, J4, J7, J10, J12, J13, J14, J15, J16: Conn_01x01_Female; PinSocket_1x01_P2.00mm_Vertical
J5, J9, J17: Conn_01x02_Female; PinSocket_1x02_P2.00mm_Vertical
J6, J11: Conn_01x03_Female; PinSocket_1x03_P2.00mm_Vertical
J8: Conn_01x04_Female; PinSocket_1x04_P2.00mm_Vertical
Q1, Q2, Q3, Q4, Q5, Q6, Q7: BC547; TO-92_Inline
R1, R2, R10, R11, R18, R19, R20: 10k; R_Axial_DIN0204_L3.6mm_D1.6mm_P5.08mm_Horizontal
R3, R4, R5, R6, R7, R8, R9, R21, R22, R23, R24: 220; R_Axial_DIN0204_L3.6mm_D1.6mm_P5.08mm_Horizontal
R12, R15, R16, R17: 1k; R_Axial_DIN0204_L3.6mm_D1.6mm_P5.08mm_Horizontal
R13, R14: 3.3K; R_Axial_DIN0204_L3.6mm_D1.6mm_P5.08mm_Horizontal
U1: Pico; RPi_Pico_SMD_TH
U2: 4N25; DIP-6_W7.62mm
U3: Voltage_bi-converter; bi_voltage-converter

Connections:
3.3V: Q5.1 (C), Q6.1 (C), Q7.1 (C), R12.1, U1.36 (3V3), U3.10 (LV)
5V: J17.2, Q1.1 (C), Q2.1 (C), Q3.1 (C), Q4.1 (C), U1.40 (VBUS), U3.4 (HV)
COMBUSTIVEL_INFERIOR: Q7.3 (E), R17.1, U1.31 (GPIO26_ADC0)
COMBUSTIVEL_SUPERIOR: Q6.3 (E), R16.1, U1.32 (GPIO27_ADC1)
DISPLAY_A: J7.1, R3.1
DISPLAY_B: J8.4, R4.1
DISPLAY_C: J8.3, R5.1
DISPLAY_D: J8.2, R6.1
DISPLAY_E: J8.1, R7.1
DISPLAY_F: J9.2, R8.1
DISPLAY_G: J9.1, R9.1
DISPLAY_RPM_CENTESIMAL: U1.20 (GPIO15), U3.8 (LV3)
DISPLAY_RPM_MILHAR: U1.19 (GPIO14), U3.7 (LV4)
DISPLAY_VELOCIDADE_DECIMAL: U1.21 (GPIO16), U3.11 (LV2)
DISPLAY_VELOCIDADE_UNITARIO: U1.22 (GPIO17), U3.12 (LV1)
GND: J17.1, R15.2, R16.2, R17.2, U1.3 (GND), U1.38 (GND), U1.42 (GND), U3.3 (GND), U3.9 (GND)
GPIO_CLK: J11.1, U1.6 (GPIO4)
GPIO_CS: J11.2, U1.5 (GPIO3)
GPIO_SO: J11.3, U1.4 (GPIO2)
HC-12_RX: J5.1, U1.2 (GPIO1)
HC-12_TX: J5.2, U1.1 (GPIO0)
LED_AMARELO: R22.2, U1.26 (GPIO20)
LED_TEMPERATURA_CRITICA_CVT: R24.2, U1.34 (GPIO28_ADC2)
LED_VERDE: R23.2, U1.25 (GPIO19)
LED_VERMELHO: R21.2, U1.27 (GPIO21)
unnamed: C1.1, D1.1 (K), R14.1
unnamed: C1.2, J13.1, R13.2
unnamed: D1.2 (A), U2.2
unnamed: J1.1, Q1.3 (E)
unnamed: J2.1, Q2.3 (E)
unnamed: J3.1, Q3.3 (E)
unnamed: J4.1, Q4.3 (E)
unnamed: J6.1, R23.1
unnamed: J6.2, R22.1
unnamed: J6.3, R21.1
unnamed: J10.1, R24.1
unnamed: J12.1, R14.2
unnamed: J14.1, R19.2
unnamed: J15.1, R20.2
unnamed: J16.1, R18.2
unnamed: Q1.2 (B), R1.1
unnamed: Q2.2 (B), R2.1
unnamed: Q3.2 (B), R10.1
unnamed: Q4.2 (B), R11.1
unnamed: Q5.2 (B), R18.1
unnamed: Q6.2 (B), R19.1
unnamed: Q7.2 (B), R20.1
unnamed: R3.2, U1.7 (GPIO5)
unnamed: R4.2, U1.9 (GPIO6)
unnamed: R5.2, U1.10 (GPIO7)
unnamed: R6.2, U1.11 (GPIO8)
unnamed: R7.2, U1.12 (GPIO9)
unnamed: R8.2, U1.16 (GPIO12)
unnamed: R9.2, U1.17 (GPIO13)
unnamed: R12.2, U2.5
unnamed: R13.1, U2.1
RPM: U1.29 (GPIO22), U2.4
RPM_CENTESIMO_5V: R10.2, U3.2 (HV3)
RPM_MILHAR_5V: R1.2, U3.1 (HV4)
VELOCIDADE: Q5.3 (E), R15.1, U1.24 (GPIO18)
VEL_DECIMAL_5V: R2.2, U3.5 (HV2)
VEL_UNITARIO_5V: R11.2, U3.6 (HV1)

Notes on the sheet:
Sinal combustível inferior
Sinal velocidade
Display milhar RPM
Displays
Alimentação
Temperatura CVT
Indicador temperatura CVT
Velocidade
Combustível Inferior
Indicador Nível de Combustível
Sinal combustível superior
Comunicação RF
Sinal RPM+
Sinal RPM referência
Filtro RPM
Multiplexador Displays
Combustível Superior

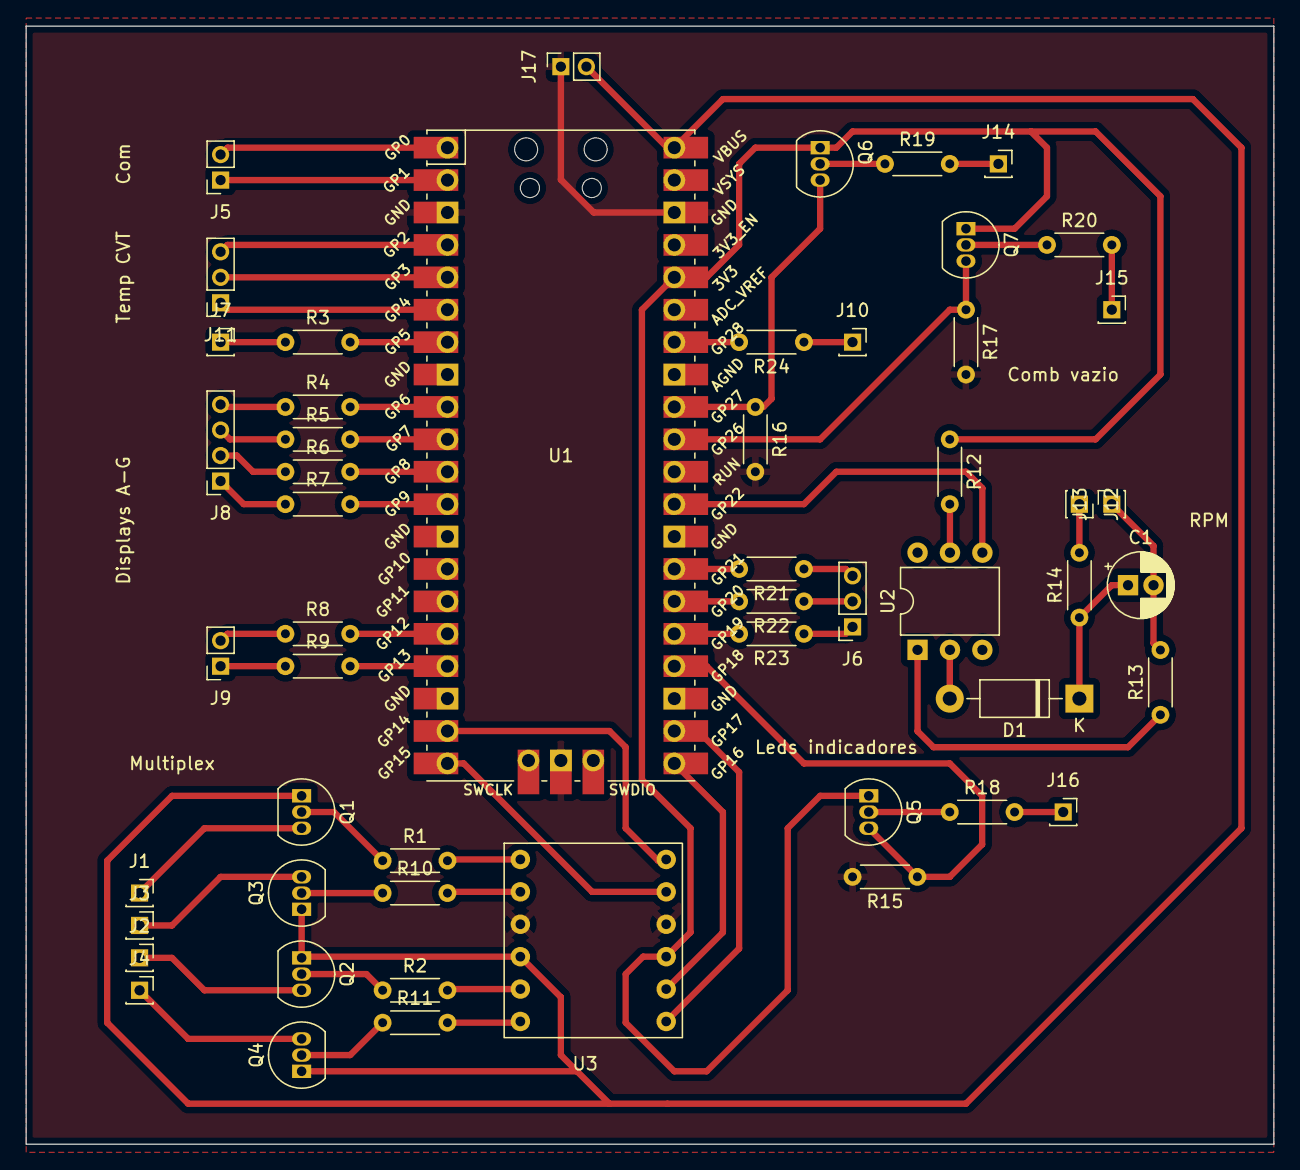
[picture p58: board main.kicad_pcb from above]

Board: 2 copper layers, 97.8 x 87.6 mm, 53 parts (0 on the bottom side), 62 nets.
