MudRunnerBaja/Eletronica/documentação/Placa Principal/Outros Documentos/4-Channel-Level-Shifter-PCB-master/Adafruit FET 4-Channel Shifter.brd

## EAGLE design documentação/Placa Principal/Outros Documentos/4-Channel-Level-Shifter-PCB-master/Adafruit FET 4-Channel Shifter.brd (2022-07-26)

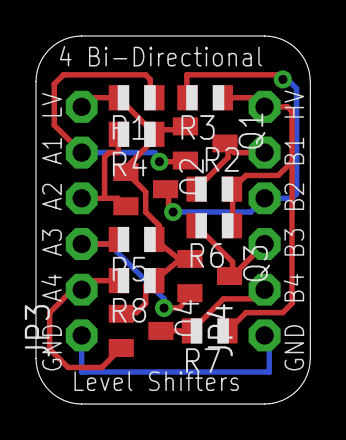
[picture p61: board Adafruit FET 4-Channel Shifter.brd from above]

Board: 2 copper layers, 15.2 x 20.4 mm, 15 parts (1 on the bottom side), 11 nets.

Parts:
JP3, JP4: 1X06-CLEANBIG
Q1, Q2, Q3, Q4: BSS138; SOT23
R1, R2, R3, R4, R5, R6, R7, R8: 10K; R0805
U$1: ADAFRUIT_3.5MM

Connections:
+3V3: JP3.6, Q1.1, Q2.1, Q3.1, Q4.1, R1.2, R4.1, R5.1, R8.1
+5V: JP4.6, R2.2, R3.1, R6.1, R7.1
GND: JP3.1, JP4.1
unnamed: JP4.3, Q3.3, R6.2
unnamed: JP4.5, Q1.3, R2.1
unnamed: JP3.3, Q3.2, R5.2
unnamed: JP3.2, Q4.2, R8.2
unnamed: JP4.2, Q4.3, R7.2
unnamed: JP3.4, Q2.2, R4.2
unnamed: JP4.4, Q2.3, R3.2
unnamed: JP3.5, Q1.2, R1.1
