MudRunnerBaja/Eletronica/testes/00-Testes_PIC/StrainGauge/ina125.brd

## EAGLE design testes/00-Testes_PIC/StrainGauge/ina125.brd (2021-08-17)

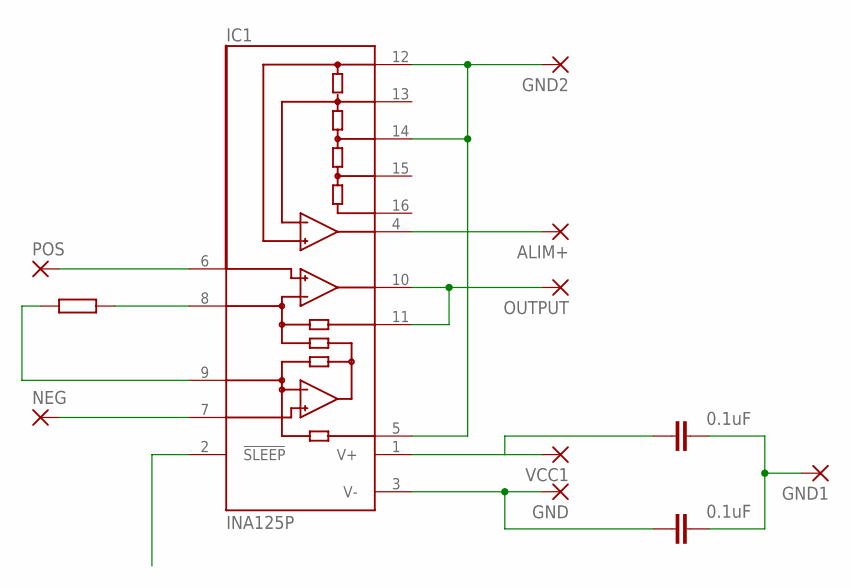
[picture p62: schematic ina125.sch]

Parts:
ALIM+: 1,6/0,8
C1, C2: 0.1uF; C2.5-3
GND, GND1, GND2: 1,6/0,8
IC1: INA125P; DIL16
NEG: 1,6/0,8
OUTPUT: 1,6/0,8
POS: 1,6/0,8
VCC1: 1,6/0,8

Connections:
unnamed: C2.1, GND.1, IC1.3 (V-)
unnamed: C1.2, C2.2, GND1.1
unnamed: C1.1, IC1.1 (V+), VCC1.1
unnamed: IC1.10 (OUT), IC1.11 (SENSE), OUTPUT.1
unnamed: IC1.6 (+IN), POS.1
unnamed: IC1.7 (-IN), NEG.1
unnamed: ALIM+.1, IC1.4 (REFOUT)
unnamed: GND2.1, IC1.5 (REF), IC1.12 (REFCOM), IC1.14 (REF2.5)

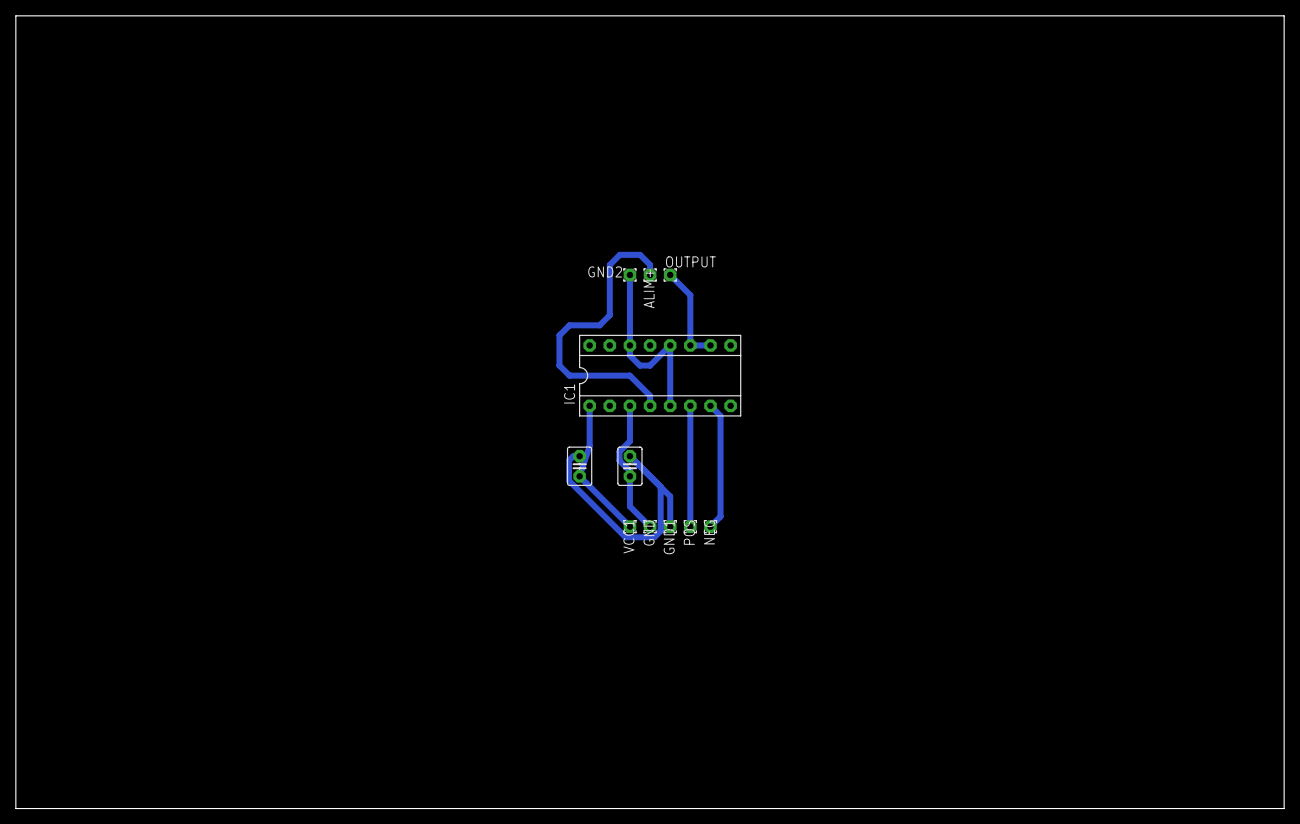
[picture p63: board ina125.brd from above]

Board: 2 copper layers, 160.0 x 100.0 mm, 11 parts (0 on the bottom side), 8 nets.
