MudRunnerBaja/Eletronica/documentação/Placa Principal/Arquivos-Fusion-Eagle/Placa Principal VF1.brd

## EAGLE design documentação/Placa Principal/Arquivos-Fusion-Eagle/Placa Principal VF1.brd (2022-07-26)

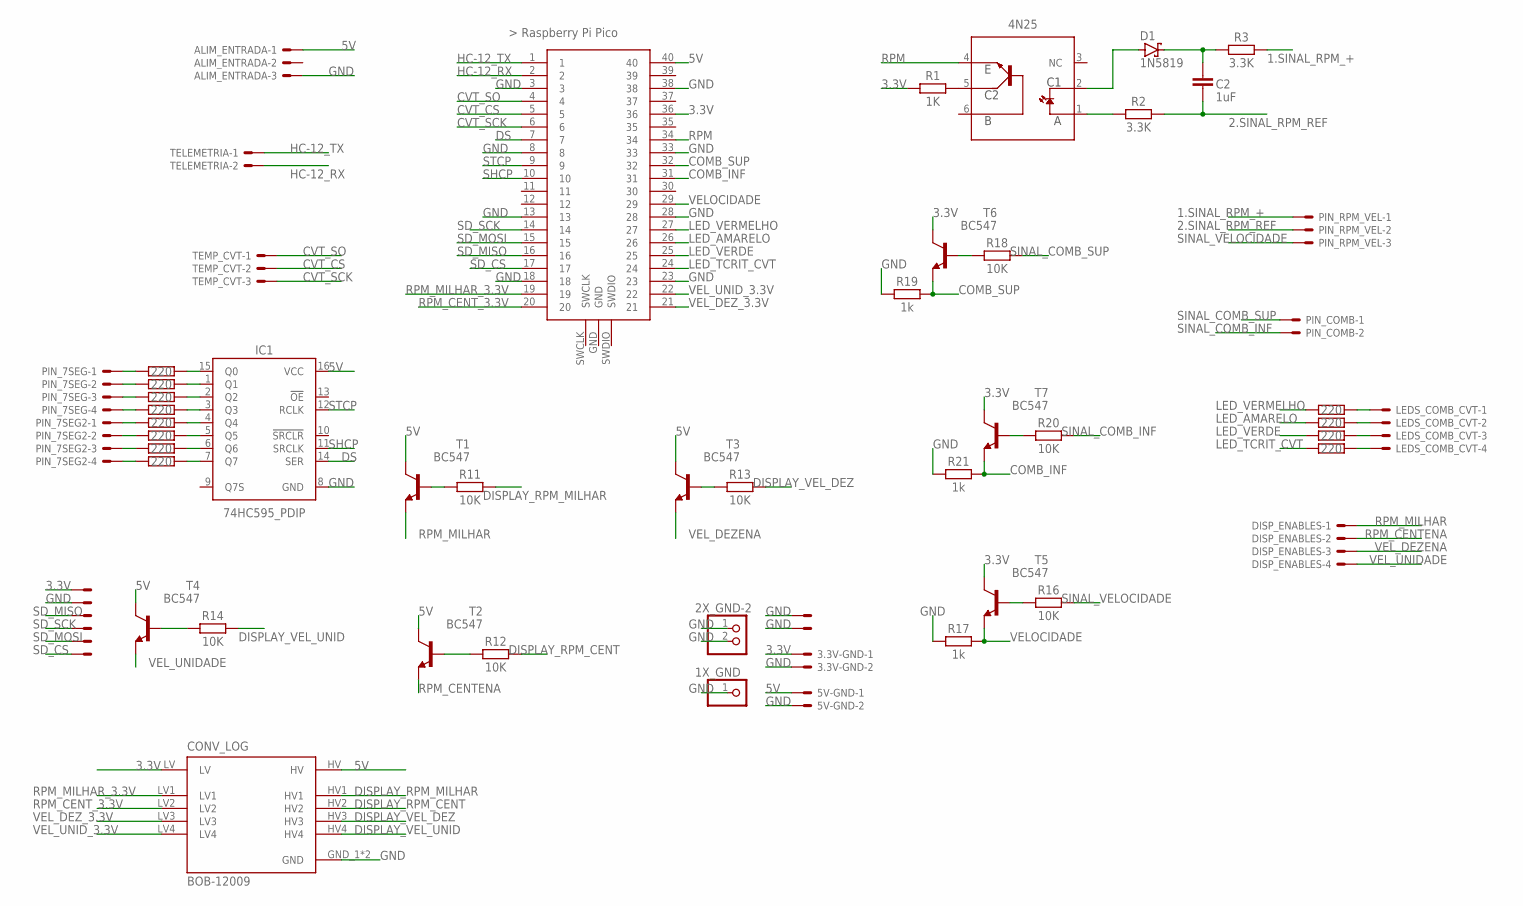
[picture p64: schematic Placa_Principal_VF1.sch]

Parts:
1X_GND: PINHD-1X1; 1X01
2X_GND, 3.3V, 3.3V-GND, 5V-GND: JST-XH-02-PIN-ROUND-PAD; JST-XH-02-PACKAGE-ROUND-PAD
2X_GND-2: PINHD-1X2; 1X02
4N25: 4N25; DIP762W60P254L712H480Q6B
ALIM_ENTRADA: JST-XH-03-PIN-ROUND-PAD; JST-XH-03-PACKAGE-ROUND-PAD
C2: 1uF; CAPRD550W60D1025H1250B
CONV_LOG: BOB-12009; CONV_BOB-12009
D1: 1N5819; DO41-7.6
DISP_ENABLES: JST-XH-04-PIN-ROUND-PAD; JST-XH-04-PACKAGE-ROUND-PAD
IC1: 74HC595_PDIP; DIP762W53P254L1969H508Q16B
LEDS_COMB_CVT: JST-XH-04-PIN-ROUND-PAD; JST-XH-04-PACKAGE-ROUND-PAD
MOD_SD: JST-XH-04-PIN-ROUND-PAD; JST-XH-04-PACKAGE-ROUND-PAD
PIN_7SEG, PIN_7SEG2: JST-XH-04-PIN-ROUND-PAD; JST-XH-04-PACKAGE-ROUND-PAD
PIN_COMB: JST-XH-02-PIN-ROUND-PAD; JST-XH-02-PACKAGE-ROUND-PAD
PIN_RPM_VEL: JST-XH-03-PIN-ROUND-PAD; JST-XH-03-PACKAGE-ROUND-PAD
R1: 1K; RESAD724W46L381D178B
R2, R3: 3.3K; RESAD724W46L381D178B
R4, R5, R6, R7, R8, R9, R10, R15, R22, R23, R24, R25: 220; RESAD724W46L381D178B
R11, R12, R13, R14, R16, R18, R20: 10K; RESAD724W46L381D178B
R17, R19, R21: 1k; RESAD724W46L381D178B
T1, T2, T3, T4, T5, T6, T7: BC547; TO92
TELEMETRIA: JST-XH-02-PIN-ROUND-PAD; JST-XH-02-PACKAGE-ROUND-PAD
TEMP_CVT: JST-XH-03-PIN-ROUND-PAD; JST-XH-03-PACKAGE-ROUND-PAD
U$2: RASPBERRY-PI-PICO_TH; FT_RASPBERRY-PI-PICO_TH

Connections:
1.SINAL_RPM_+: PIN_RPM_VEL.1, R3.2
2.SINAL_RPM_REF: C2.2, PIN_RPM_VEL.2, R2.2
3.3V: 3.3V.1, 3.3V-GND.1, CONV_LOG.LV, R1.1, T5.3 (C), T6.3 (C), T7.3 (C), U$2.36
5V: 5V-GND.1, ALIM_ENTRADA.1, CONV_LOG.HV, IC1.16 (VCC), T1.3 (C), T2.3 (C), T3.3 (C), T4.3 (C), U$2.40; also elsewhere on the board
COMB_INF: R21.2, T7.1 (E), U$2.31
COMB_SUP: R19.2, T6.1 (E), U$2.32
CVT_CS: TEMP_CVT.2, U$2.5
CVT_SCK: TEMP_CVT.3, U$2.6
CVT_SO: TEMP_CVT.1, U$2.4
DISPLAY_RPM_CENT: CONV_LOG.HV2, R12.2
DISPLAY_RPM_MILHAR: CONV_LOG.HV1, R11.2
DISPLAY_VEL_DEZ: CONV_LOG.HV3, R13.2
DISPLAY_VEL_UNID: CONV_LOG.HV4, R14.2
DS: IC1.14 (SER), U$2.7
GND: 1X_GND.1, 2X_GND.1, 2X_GND.2, 2X_GND-2.1, 2X_GND-2.2, 3.3V.2, 3.3V-GND.2, 5V-GND.2, ALIM_ENTRADA.3, CONV_LOG.GND_1 (GND), CONV_LOG.GND_2 (GND), IC1.8 (GND), R17.1, R19.1, R21.1, U$2.3, U$2.8, U$2.13, U$2.18, U$2.23, U$2.28, U$2.33, U$2.38; also elsewhere on the board
HC-12_RX: TELEMETRIA.2, U$2.2
HC-12_TX: TELEMETRIA.1, U$2.1
LED_AMARELO: R22.1, U$2.26
LED_TCRIT_CVT: R24.1, U$2.24
LED_VERDE: R23.1, U$2.25
LED_VERMELHO: R15.1, U$2.27
unnamed: 4N25.2 (C1), D1.A
unnamed: 4N25.1 (A), R2.1
unnamed: R16.1, T5.2 (B)
unnamed: C2.1, D1.C, R3.1
unnamed: R11.1, T1.2 (B)
unnamed: 4N25.5 (C2), R1.2
unnamed: IC1.15 (Q0), R4.2
unnamed: IC1.1 (Q1), R5.2
unnamed: IC1.2 (Q2), R6.2
unnamed: LEDS_COMB_CVT.1, R15.2
unnamed: R12.1, T2.2 (B)
unnamed: IC1.3 (Q3), R7.2
unnamed: IC1.4 (Q4), R8.2
unnamed: R13.1, T3.2 (B)
unnamed: IC1.5 (Q5), R9.2
unnamed: R18.1, T6.2 (B)
unnamed: LEDS_COMB_CVT.2, R22.2
unnamed: R14.1, T4.2 (B)
unnamed: IC1.6 (Q6), R10.2
unnamed: LEDS_COMB_CVT.3, R23.2
unnamed: R20.1, T7.2 (B)
unnamed: LEDS_COMB_CVT.4, R24.2
unnamed: IC1.7 (Q7), R25.2
unnamed: PIN_7SEG.1, R4.1
unnamed: PIN_7SEG.2, R5.1
unnamed: PIN_7SEG.3, R6.1
unnamed: PIN_7SEG.4, R7.1
unnamed: PIN_7SEG2.1, R8.1
unnamed: PIN_7SEG2.2, R9.1
unnamed: PIN_7SEG2.3, R10.1
unnamed: PIN_7SEG2.4, R25.1
RPM: 4N25.4 (E), U$2.34
RPM_CENTENA: DISP_ENABLES.2, T2.1 (E)
RPM_CENT_3.3V: CONV_LOG.LV2, U$2.20
RPM_MILHAR: DISP_ENABLES.1, T1.1 (E)
RPM_MILHAR_3.3V: CONV_LOG.LV1, U$2.19
SD_CS: MOD_SD.4, U$2.17
SD_MISO: MOD_SD.1, U$2.16
SD_MOSI: MOD_SD.3, U$2.15
SD_SCK: MOD_SD.2, U$2.14
SHCP: IC1.11 (SRCLK), U$2.10
SINAL_COMB_INF: PIN_COMB.2, R20.2
SINAL_COMB_SUP: PIN_COMB.1, R18.2
SINAL_VELOCIDADE: PIN_RPM_VEL.3, R16.2
STCP: IC1.12 (RCLK), U$2.9
VELOCIDADE: R17.2, T5.1 (E), U$2.29
VEL_DEZENA: DISP_ENABLES.3, T3.1 (E)
VEL_DEZ_3.3V: CONV_LOG.LV3, U$2.21
VEL_UNIDADE: DISP_ENABLES.4, T4.1 (E)
VEL_UNID_3.3V: CONV_LOG.LV4, U$2.22

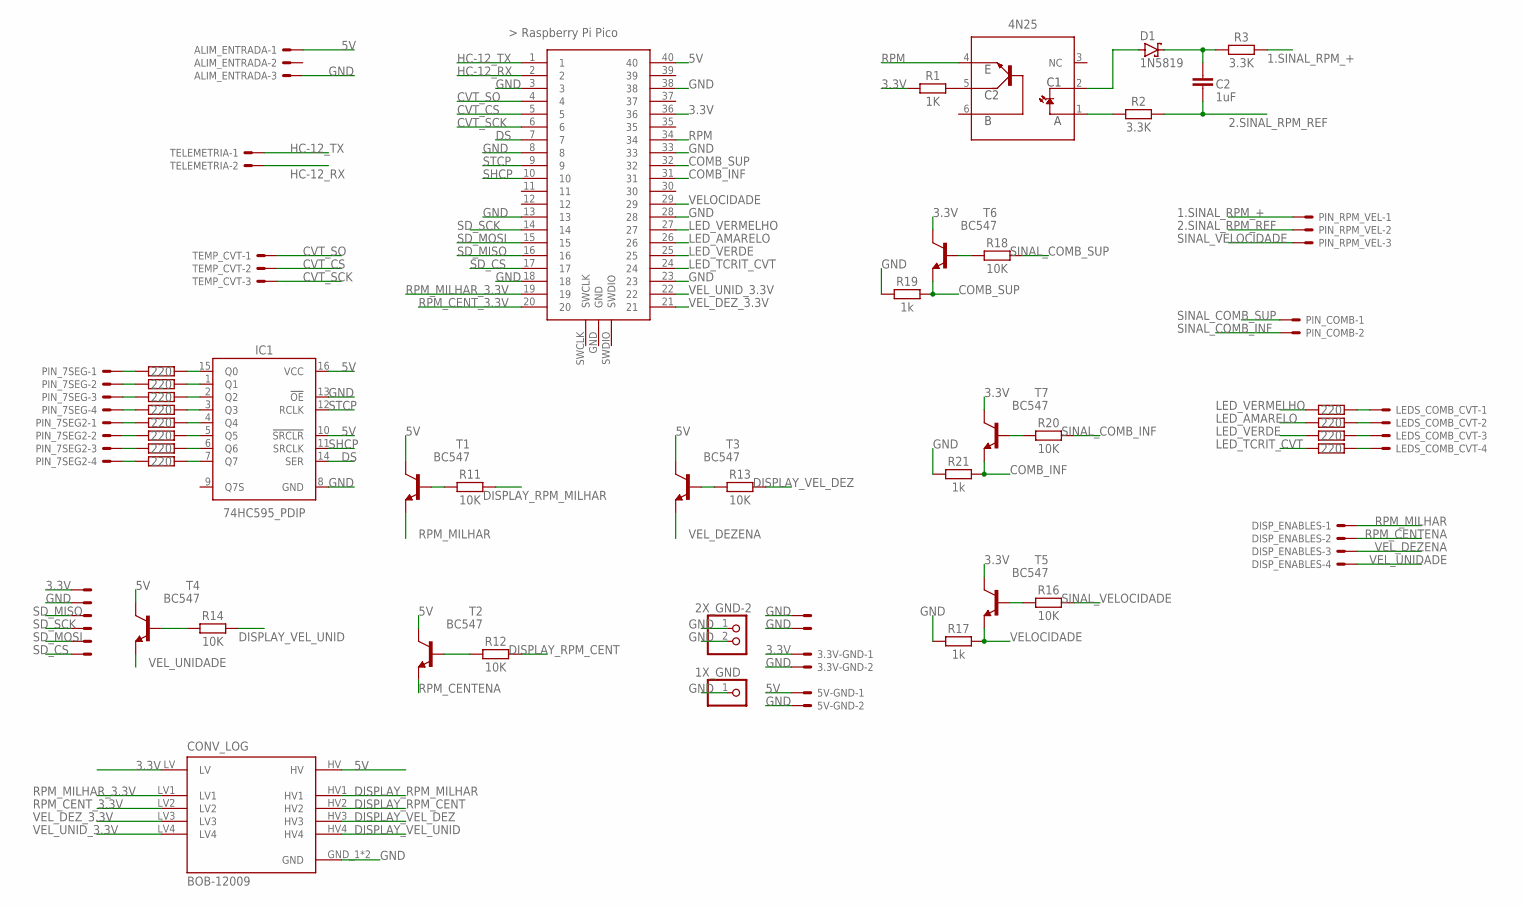
[picture p65: schematic Placa_Principal_VF.sch]

Parts:
1X_GND: PINHD-1X1; 1X01
2X_GND, 3.3V, 3.3V-GND, 5V-GND: JST-XH-02-PIN-ROUND-PAD; JST-XH-02-PACKAGE-ROUND-PAD
2X_GND-2: PINHD-1X2; 1X02
4N25: 4N25; DIP762W60P254L712H480Q6B
ALIM_ENTRADA: JST-XH-03-PIN-ROUND-PAD; JST-XH-03-PACKAGE-ROUND-PAD
C2: 1uF; CAPRD550W60D1025H1250B
CONV_LOG: BOB-12009; CONV_BOB-12009
D1: 1N5819; DO41-7.6
DISP_ENABLES: JST-XH-04-PIN-ROUND-PAD; JST-XH-04-PACKAGE-ROUND-PAD
IC1: 74HC595_PDIP; DIP762W53P254L1969H508Q16B
LEDS_COMB_CVT: JST-XH-04-PIN-ROUND-PAD; JST-XH-04-PACKAGE-ROUND-PAD
MOD_SD: JST-XH-04-PIN-ROUND-PAD; JST-XH-04-PACKAGE-ROUND-PAD
PIN_7SEG, PIN_7SEG2: JST-XH-04-PIN-ROUND-PAD; JST-XH-04-PACKAGE-ROUND-PAD
PIN_COMB: JST-XH-02-PIN-ROUND-PAD; JST-XH-02-PACKAGE-ROUND-PAD
PIN_RPM_VEL: JST-XH-03-PIN-ROUND-PAD; JST-XH-03-PACKAGE-ROUND-PAD
R1: 1K; RESAD724W46L381D178B
R2, R3: 3.3K; RESAD724W46L381D178B
R4, R5, R6, R7, R8, R9, R10, R15, R22, R23, R24, R25: 220; RESAD724W46L381D178B
R11, R12, R13, R14, R16, R18, R20: 10K; RESAD724W46L381D178B
R17, R19, R21: 1k; RESAD724W46L381D178B
T1, T2, T3, T4, T5, T6, T7: BC547; TO92
TELEMETRIA: JST-XH-02-PIN-ROUND-PAD; JST-XH-02-PACKAGE-ROUND-PAD
TEMP_CVT: JST-XH-03-PIN-ROUND-PAD; JST-XH-03-PACKAGE-ROUND-PAD
U$2: RASPBERRY-PI-PICO_TH; FT_RASPBERRY-PI-PICO_TH

Connections:
1.SINAL_RPM_+: PIN_RPM_VEL.1, R3.2
2.SINAL_RPM_REF: C2.2, PIN_RPM_VEL.2, R2.2
3.3V: 3.3V.1, 3.3V-GND.1, CONV_LOG.LV, R1.1, T5.3 (C), T6.3 (C), T7.3 (C), U$2.36
5V: 5V-GND.1, ALIM_ENTRADA.1, CONV_LOG.HV, IC1.10 (!SRCLR), IC1.16 (VCC), T1.3 (C), T2.3 (C), T3.3 (C), T4.3 (C), U$2.40
COMB_INF: R21.2, T7.1 (E), U$2.31
COMB_SUP: R19.2, T6.1 (E), U$2.32
CVT_CS: TEMP_CVT.2, U$2.5
CVT_SCK: TEMP_CVT.3, U$2.6
CVT_SO: TEMP_CVT.1, U$2.4
DISPLAY_RPM_CENT: CONV_LOG.HV2, R12.2
DISPLAY_RPM_MILHAR: CONV_LOG.HV1, R11.2
DISPLAY_VEL_DEZ: CONV_LOG.HV3, R13.2
DISPLAY_VEL_UNID: CONV_LOG.HV4, R14.2
DS: IC1.14 (SER), U$2.7
GND: 1X_GND.1, 2X_GND.1, 2X_GND.2, 2X_GND-2.1, 2X_GND-2.2, 3.3V.2, 3.3V-GND.2, 5V-GND.2, ALIM_ENTRADA.3, CONV_LOG.GND_1 (GND), CONV_LOG.GND_2 (GND), IC1.8 (GND), IC1.13 (!OE), R17.1, R19.1, R21.1, U$2.3, U$2.8, U$2.13, U$2.18, U$2.23, U$2.28, U$2.33, U$2.38
HC-12_RX: TELEMETRIA.2, U$2.2
HC-12_TX: TELEMETRIA.1, U$2.1
LED_AMARELO: R22.1, U$2.26
LED_TCRIT_CVT: R24.1, U$2.24
LED_VERDE: R23.1, U$2.25
LED_VERMELHO: R15.1, U$2.27
unnamed: 4N25.2 (C1), D1.A
unnamed: 4N25.1 (A), R2.1
unnamed: R16.1, T5.2 (B)
unnamed: C2.1, D1.C, R3.1
unnamed: R11.1, T1.2 (B)
unnamed: 4N25.5 (C2), R1.2
unnamed: IC1.15 (Q0), R4.2
unnamed: IC1.1 (Q1), R5.2
unnamed: IC1.2 (Q2), R6.2
unnamed: LEDS_COMB_CVT.1, R15.2
unnamed: R12.1, T2.2 (B)
unnamed: IC1.3 (Q3), R7.2
unnamed: IC1.4 (Q4), R8.2
unnamed: R13.1, T3.2 (B)
unnamed: IC1.5 (Q5), R9.2
unnamed: R18.1, T6.2 (B)
unnamed: LEDS_COMB_CVT.2, R22.2
unnamed: R14.1, T4.2 (B)
unnamed: IC1.6 (Q6), R10.2
unnamed: LEDS_COMB_CVT.3, R23.2
unnamed: R20.1, T7.2 (B)
unnamed: LEDS_COMB_CVT.4, R24.2
unnamed: IC1.7 (Q7), R25.2
unnamed: PIN_7SEG.1, R4.1
unnamed: PIN_7SEG.2, R5.1
unnamed: PIN_7SEG.3, R6.1
unnamed: PIN_7SEG.4, R7.1
unnamed: PIN_7SEG2.1, R8.1
unnamed: PIN_7SEG2.2, R9.1
unnamed: PIN_7SEG2.3, R10.1
unnamed: PIN_7SEG2.4, R25.1
RPM: 4N25.4 (E), U$2.34
RPM_CENTENA: DISP_ENABLES.2, T2.1 (E)
RPM_CENT_3.3V: CONV_LOG.LV2, U$2.20
RPM_MILHAR: DISP_ENABLES.1, T1.1 (E)
RPM_MILHAR_3.3V: CONV_LOG.LV1, U$2.19
SD_CS: MOD_SD.4, U$2.17
SD_MISO: MOD_SD.1, U$2.16
SD_MOSI: MOD_SD.3, U$2.15
SD_SCK: MOD_SD.2, U$2.14
SHCP: IC1.11 (SRCLK), U$2.10
SINAL_COMB_INF: PIN_COMB.2, R20.2
SINAL_COMB_SUP: PIN_COMB.1, R18.2
SINAL_VELOCIDADE: PIN_RPM_VEL.3, R16.2
STCP: IC1.12 (RCLK), U$2.9
VELOCIDADE: R17.2, T5.1 (E), U$2.29
VEL_DEZENA: DISP_ENABLES.3, T3.1 (E)
VEL_DEZ_3.3V: CONV_LOG.LV3, U$2.21
VEL_UNIDADE: DISP_ENABLES.4, T4.1 (E)
VEL_UNID_3.3V: CONV_LOG.LV4, U$2.22

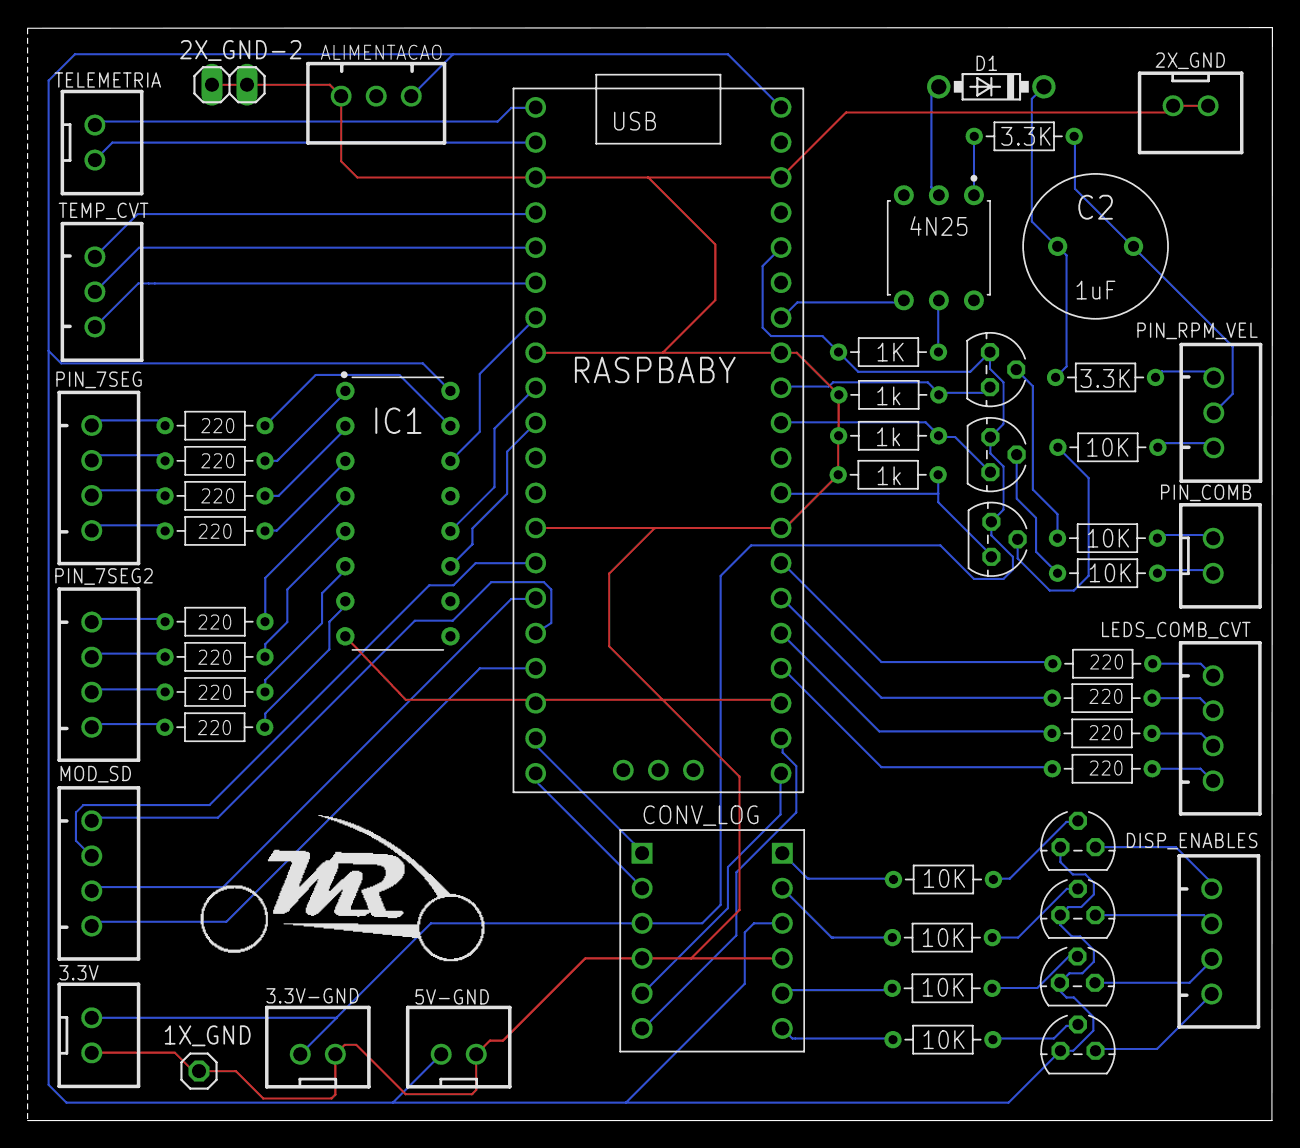
[picture p66: board Placa Principal VF1.brd from above]

Board: 2 copper layers, 90.2 x 79.2 mm, 54 parts (0 on the bottom side), 71 nets.
