MudRunnerBaja/Eletronica/testes/CAN-BUS/CANReceiver/CANReceiver.ino

// Copyright (c) Sandeep Mistry. All rights reserved.
// Licensed under the MIT license. See LICENSE file in the project root for full license information.

#include <CAN.h>

#define sck 6
#define rx 4  //MISO
#define tx 7  //MOSI
#define cs 5 


void setup() {
  Serial.begin(9600);
  while (!Serial);
  delay(2000);
  Serial.println("CAN Receiver");

  SPI.setSCK(sck);
  SPI.setRX(rx);
  SPI.setTX(tx);

  CAN.setPins(cs);


  // start the CAN bus at 500 kbps
  if (!CAN.begin(500E3)) {
    Serial.println("Starting CAN failed!");
    while (1);
  }
}

void loop() {
  // try to parse packet
  int packetSize = CAN.parsePacket();

  if (packetSize) {
    // received a packet
    Serial.print("Received ");

    if (CAN.packetExtended()) {
      Serial.print("extended ");
    }

    if (CAN.packetRtr()) {
      // Remote transmission request, packet contains no data
      Serial.print("RTR ");
    }

    Serial.print("packet with id 0x");
    Serial.print(CAN.packetId(), HEX);

    if (CAN.packetRtr()) {
      Serial.print(" and requested length ");
      Serial.println(CAN.packetDlc());
    } else {
      Serial.print(" and length ");
      Serial.println(packetSize);

      // only print packet data for non-RTR packets
      while (CAN.available()) {
        Serial.print((char)CAN.read());
      }
      Serial.println();
    }

    Serial.println();
  }
}
