MudRunnerBaja/Eletronica/testes/CAN-BUS/CANSender/CANSender.ino

// Copyright (c) Sandeep Mistry. All rights reserved.
// Licensed under the MIT license. See LICENSE file in the project root for full license information.

#include <CAN.h>
#include <SPI.h>

#define sck 18
#define rx 16  //MISO
#define tx 19  //MOSI
#define cs 17 


void setup() {
  Serial.begin(9600);
  while (!Serial);
  delay(2000);

  SPI.setSCK(sck);
  SPI.setRX(rx);
  SPI.setTX(tx);

  CAN.setPins(cs);

  Serial.println("CAN Sender");
  // start the CAN bus at 500 kbps
  if (!CAN.begin(500E3)) {
    Serial.println("Starting CAN failed!");
    while (1);
  }
}

void loop() {
  // send packet: id is 11 bits, packet can contain up to 8 bytes of data
  Serial.print("Sending packet ... ");

  CAN.beginPacket(0x12);
  CAN.write('h');
  CAN.write('e');
  CAN.write('l');
  CAN.write('l');
  CAN.write('o');
  CAN.endPacket();

  Serial.println("done");

  delay(1000);

  // send extended packet: id is 29 bits, packet can contain up to 8 bytes of data
  Serial.print("Sending extended packet ... ");

  CAN.beginExtendedPacket(0xabcdef);
  CAN.write('w');
  CAN.write('o');
  CAN.write('r');
  CAN.write('l');
  CAN.write('d');
  CAN.endPacket();

  Serial.println("done");

  delay(1000);
}
