MudRunnerBaja/Eletronica/codigos/Placa_Central/main/include/Freio.h

/**
 * Project Classes Placa Central
 *
 * Aquisição do nível do líquido de freio e da pressão de freio
 *
 * Pressão:
 * 0.5V à 4.5V
 * 0 MPa à 60 MPa
 */

#ifndef _FREIO_H
#define _FREIO_H

#include "Setupable.h"
#include "Constantes.h"

class Freio : public Setupable
{
public:
    Freio()
    {
        return;
    }

    /**
     * @return bool
     */
    bool Setup()
    {
        pinMode(NIVEL_FREIO, INPUT);
        pinMode(PRESSAO_FREIO, INPUT);

        return true;
    }

    /**
     * @return bool
     */
    bool Loop()
    {
        return true;
    }

    /**
     * @return bool
     */
    bool Debug()
    {
        return false;
    }

    int setNivelAtual()
    {
        nivelAtual = digitalRead(NIVEL_FREIO);
        return nivelAtual;
    }

    int setPressaoAtual()
    {
        pressaoAtual = calculaPressao();
        return pressaoAtual;
    }

    double calculaPressao()
    {
        // 3.3V = 4095 = 60 MPA
        // < 0.5V? = 0 = 0 MPA
        // +/- 0.1V = 146,25 = 2.1428 MPA

        int leitura = analogRead(PRESSAO_FREIO);

        return (((double)leitura / 146.25) * 2.1428);
    }

    int getNivelAtual()
    {
        return nivelAtual;
    }

    double getPressaoAtual()
    {
        return pressaoAtual;
    }

private:
    int nivelAtual;
    double pressaoAtual;
};

#endif //_FREIO_H
