MudRunnerBaja/Eletronica/codigos/Placa_Central/main/include/TensaoBateria.h

/**
 * Project Classes Placa Central
 */

#ifndef _TENSAOBATERIA_H
#define _TENSAOBATERIA_H

#include "Setupable.h"
#include "Constantes.h"

class TensaoBateria : public Setupable
{
public:
    bool Setup()
    {
        pinMode(DIV_TENSAO, INPUT);
        return true;
    }

    bool Loop()
    {
        return false;
    }

    double updateTensaoBateria()
    {
        tensaoBateria;
        return tensaoBateria;
    }

    bool Debug()
    {
        return false;
    }

    double getTensaoBateria()
    {
        return tensaoBateria;
    }

private:
    double tensaoBateria;
};

#endif //_TENSAOBATERIA_H
