MudRunnerBaja/Eletronica/competição/RaspbabyPico/main/include/rpm.cpp

/* 
    Implementação da contagem de rpm do carro 
*/

int rpmInputPin = 28;
int rpmCounter = 0;
int rpmGlobal;

float setRpm()
{
    rpmGlobal = rpmCounter * 60;
    rpmCounter = 0;
    return rpmGlobal;
}

float getRpm()
{
    return rpmGlobal;
}

void rpmCounterFunc()
{
    rpmCounter++;
}

void setupRpm()
{
    attachInterrupt(digitalPinToInterrupt(rpmInputPin), rpmCounterFunc, RISING);
}
