MudRunnerBaja/Eletronica/(commit log)

2020-05-06 gps e mikro C
    adicionando código com simulações usando gps e o instalador do mikro C com tutorial
    [comDisplay.pdsprj, semDisplay.pdsprj]
2020-05-06 Adicionando cod de aceleração e retomada no git
2020-05-06 correção bugs e simulação proteus
    adicionando simulação proteus
    [testeRetomada.pdsprj]
2020-05-07 teste com 2 pics e codigo de cada um
    adicionando teste com 1 pic para coleta de dados e outro para exibição no display com seus respectivos codigos
    [testeComDoisPics.pdsprj]
2020-05-07 pic 18f458
    alteração do pic do display para o pic 18f458
    [testeComDoisPics.pdsprj]
2020-05-07 codigo certo
    correção de erros do codigo do arduino 30metros e arduino principal
    [testeRetomada.pdsprj]
2020-05-12 Colocando a comunicação com o sensor rf
    Funcionando a lógica de largada, 30m e retomada
2020-05-12 Adicionada comunicação com sensor rf
    Lógica de largada,30m e retomada feitas
2020-05-15 Adicionada a lógica de 2 receptores
    Fiz 2 softwares serial para receber os dados do carro e do sensor
2020-05-20 temperatura da cvt
    adicionando simulação no proteus, código e arquivo hexadecimal para a simulação
    [tempcvt.pdsprj]
2020-05-21 adicionando simulação completa
    adicionando a ultima versão com temperatura da CVT e GPS no circuito principal do carro
    [ultimaVersao.pdsprj]
2020-05-21 organizando o git
    [projetoAntigo.pdsprj, semDisplay.pdsprj, testeComDoisPics.pdsprj, testeRetomada.pdsprj]
2020-06-02 Codigo de telemetria(novo)
2020-07-18 Temperatura IR PIC
    Código sem testagem ainda (não há esse sensor no proteus).
2021-08-17 Reestruturação do git
    [Circuito_completo.pdsprj, Medidor_Combustível.pdsprj, RPM.pdsprj, Teste_rpm_circuitonovo.pdsprj, Teste_rpm_filtro_2.pdsprj, box.pdsprj, coeficiente_de_atrito.pdsprj, gauge.pdsprj]
2021-08-18 Empacotado o teste de vibração
2021-08-23 Finalizando arrumação do github
    [Circuito_completo.pdsprj, Medidor_Combustível.pdsprj, RPM.pdsprj, Teste_rpm_circuitonovo.pdsprj, Teste_rpm_filtro_2.pdsprj, coeficiente_de_atrito.pdsprj, gauge.pdsprj, ina125.brd]
2021-08-23 Iniciando telemetria e re-organização das pastas
    [Circuito_completo.pdsprj]
2021-09-06 Visual dashboard de controle
2022-02-09 TEMPERATURA PI PICO
2022-02-21 Organização estrutura código arduino
2022-02-24 Atualizações no servidor para se adequar ao heroku
2022-04-07 Atualização de pinos + alterações servidor
2022-04-12 Corrigindo velocidade
2022-04-12 Adicionando esquemático elétrico
    [Pico.skp, Test.kicad_pcb, Test.kicad_sch, main.kicad_pcb, main.kicad_sch]
2022-04-15 Esquema da placa do display
    [Esquema displays.xlsx]
2022-07-26 Atualização Código e Placa Principal
    - Correção de alguns bugs no código do PICO;
    - Adição de arquivos de documentação e outras referências para compreensão e modificação do código e sistema;
    - Adição dos documentos da nova placa principal;
    - Arquivos sobre sistemas não mais usados foram movidos e sinalizados;
    - Adição da biblioteca do ShiftRegister 74HC, ainda não utilizada no código
    - O Raspberry Pi Pico agora é oficialmente chamado de Raspbaby Pico
    [Adafruit FET 4-Channel Shifter.brd, Adafruit FET 4-Channel Shifter.sch, Circuito_completo.pdsprj, Esquema displays.xlsx, Pico.skp, Placa Principal VF1.brd, Placa_Principal_VF1.sch, Test.kicad_pcb]
2022-07-27 Atualização da Placa Principal
    Corrigido um pequeno erro nas trilhas e adicionada uma pequena modificação no design
    [Placa Principal VF.brd, Placa_Principal_VF.sch]
2022-08-08 Fiação MR21
    - Adição da documentação da fiação do MR21
    - Pequenas mudanças na organização das pastas
    [Fiação MR21 v8.f3z, Placa Principal VF.brd, Placa Principal VF1.brd, Placa_Principal_VF.sch, Placa_Principal_VF1.sch, gauge.pdsprj, ina125.brd, ina125.sch]
2022-08-17 Adicionado a função de velocidade
2022-08-18 Adicionado RTC e correção de bugs
    [cvt_tunning.ino]
2022-08-18 Corrigida informações a ser gravadas no cartão SD
    [cvt_tunning.ino]
2022-08-22 Novas funções e corrigido erros de gravação
    [cvt_tunning.ino]
2022-08-23 Corrigido o calculo da velocidade
    [cvt_tunning.ino]
2022-08-23 Correção de bugs
2022-08-29 Atualização Código Placa Principal
    - Placa do display controlada pelo registrador de deslocamento;
    - Códigos mais fáceis de entender;
    - Adicionada pasta com adesivos para o painel do carro
2022-08-31 Portas corrigidas para o novo modelo de placa
    [comb.cpp, main.ino, sdcard.cpp, temp.cpp, vel.cpp]
2022-09-07 SOS Display
    Por algum motivo os displays de 7 segmentos não quer funcionar:
    O resto do código parece funcionar ok;
    Por enquanto focar em entregar o nível de combustível para o piloto;
    O problema nos displays pode tanto ser falha elétrica quanto código. Por algum motivo o registrador de deslocamento não se comporta conforme esperado
    [display.c, gps.c, main.ino, sdcard.c, vel.c]
2022-09-20 IC Charlieplexado
    Tentativa de manter o brilho do display reduzindo o consumo de corrente. Se bem sucedido:
    - Mantém o projeto da placa
    - Mantém o custo dos componentes da placa
    - Evita o uso de gambiarras e soluções externas (como placas com transistores)
2022-09-21 Corrida velocidade
2022-09-22 Organização Arquivos
    [Adafruit FET 4-Channel Shifter.brd, Adafruit FET 4-Channel Shifter.sch, Placa Principal VF.brd, Placa Principal VF1.brd, Placa_Principal_VF.sch, Placa_Principal_VF1.sch]
2022-09-30 Implementado múltipla criação de arquivos no SD
2022-10-06 Organização dos Arquivos
    [Circuito_completo.pdsprj, Esquema displays.xlsx, Pico.skp, Test.kicad_pcb, Test.kicad_sch, main.kicad_pcb, main.kicad_sch, projetoAntigo.pdsprj]
2022-10-20 Update SDCard
    [Adafruit FET 4-Channel Shifter.brd, Adafruit FET 4-Channel Shifter.sch, Circuito_completo.pdsprj, Esquema displays.xlsx, Pico.skp, Placa Principal VF1.brd, Placa_Principal_VF1.sch, Test.kicad_pcb]
2022-10-24 Reorganização
    [(old)Esquema displays.xlsx, Adafruit FET 4-Channel Shifter.brd, Adafruit FET 4-Channel Shifter.sch, Circuito_completo.pdsprj, Esquema displays.xlsx, Fiação MR21 v8.f3z, Pico.skp, Placa Principal VF.brd]
2022-10-25 Revert "Update sdcard.c"
    This reverts commit ab002c03ba32cec3cbdfa6e41cc4ba4b598456bb.
    [sdcard.c]
2022-11-04 Esquemática do novo filtro de RPM
    [Filtro RPM 2022.pdsprj]
2022-11-30 Adição do Relatório de Workflow
    Para a equipe consultar no caso de dúvidas quanto a como trabalhar com o github.
    A ser adicionado instruções para mesclagem de branches.
2022-12-21 Corrigido alguns bugs (gps)
    Ainda faltam corrigir erros na gravação dos dados do gps no sd
    [gps.c, sdcard.c]
2022-12-22 Setup timer e getcomb
2022-12-22 interrupt callback core1/sd
2022-12-22 Separação das tarefas dos nucleos (display/writedata/sensores)
2022-12-23 Gravação do GPS no SD (com alguns bugs)
    A fazer:
    Corrigir informações gravadas a mais e na mesma linha
    Retirar coisas inúteis do código
    [gps.c, main.ino, sdcard.c]
2022-12-23 Gravação do GPS no SD (com alguns bugs) #2
    (Ultimo commit foi incompleto)
    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
    [gps.c]
2022-12-25 Corrigido erro na atribuição de uma função
    [gps.c]
2023-01-19 Criado funções de contagem de tempo
    Criado para implementar funções de tempo de rodagem e tempo de funcionamento do motor.
2023-01-19 Código-Teste para Otimização
    Limitando tempo de encoding do GPS para evitar prender o processador por longos períodos de tempo;
    Checagem se os dados salvos foram recentemente atualizados ou não;
    É necessário reestruturar o sistema de biblioteca
2023-01-29 Implementado a interface de configuração
    Ainda a fazer:
    Salvar horário usando o gps
    Não gravar dados enquanto o gps não estiver sincronizado com os satelites
2023-01-31 Interface otimizada e adotado Serial por hardware
    Implementado gravação de tempo
    Interface otimizada
2023-01-31 blink test
    master inverte a logica do led a cada meio segundo e envia para o slave
    o slave recebe, salva e acende ou apaga o led
    alimentações independentes
2023-02-12 Contador de rpm da movida
2023-02-14 TENTANDO I2C ENTRE PICOS
2023-02-16 Fix i2c
2023-02-17 Remove Output and Fix Declarations
    [74hcCodigo.c, cvt_tunning.c, display.c, displayAlternativo.c, gps.c, main.ino, sdcard.c, vel.c]
2023-02-24 Fix filename
    Os programa sempre abria o arquivo dados000.csv, ao inves de criar novos
    [sdcard.c]
2023-03-13 Adicionado PWM nos LEDS
    - Controle dos LED's do indicador de combustível por PWM
    - Corrigido valor do RPM máximo
    - Corrigido texto de inicialização
    - Limpeza do código
    [UnoLCD-Slave.ino]
2023-04-05 Add files via upload
    Teste simples! Só para ver quando o receptor parou de receber!
2023-04-18 Codigo atualizado para sensor modificado
2023-05-18 Troca de portas
2023-05-31 Atualizando Testes de Telemetria
    Agora envia uma data que é quebrada em dias/mes/ano de um sender para um receiver.
    a distância do sinal chegou a 130m sem obstruções tranquilamente.
2023-07-06 Teste de Distancia Standalone adicionado
2023-07-06 Teste de confiabilidade (em andamento)
2023-07-06 Teste comunicacao serial1 e serial2 pico consigo mesmo (Sem sucesso)
2023-08-01 Atualizado pra main. Precisa de revisao
2023-08-15 Teste de gravações múltiplas no flash
2023-12-11 Configurações de projeto de telemetria
2023-12-11 readme e configurações de projeto
2023-12-15 Teste pico-lora-ft232 para telemetria
2023-12-16 Teste telemetria pico-ft232 adaptado
2023-12-28 mongo/mongoose thiago
    Tentativa de junção com o protótipo que fiz usando mongo
2024-01-09 concertei minha o erro que estava acontecendo antes
2024-01-16 backend frontend socket io
    comunicação usando socket.io
2024-01-24 json stringfy arduino data back -> front
2024-01-29 restauração dos arquivos do projeto antes de reinciar
2024-02-20 Nova proposta de estrutura do codigo da placa central
2024-02-20 Adicao de libs ao novo sketch placa central
2024-02-28 Ajustes estrutura codigo para comunicacao LoRa
2024-02-29 Libs sensor temperatura mlx90614
2024-02-29 Correcao organizacoes de classes e metodos
2024-03-05 Adicionado codigo de testes CAN-BUS
2024-03-06 Codigos de teste CAN-BUS funcional
2024-03-14 Update testePrototipoMR23.ino
    Problemas com o Serial1 do gps
    [testePrototipoMR23.ino]
2024-03-19 estruturando codigo de teste WIP
2024-03-23 Estruturacao das bibliotecas compilavel para arduino-pico
2024-05-14 Teste do limite de rpm
2024-05-21 Implementacoes simplificadas dos sistemas de aquisicao de dados
2024-05-24 WIP refatoracao telemetria - separacao da logica e configuracao de infra
